rnibor/AgOpenGPS_BoardsKeya/TeensyModules/V4.1/Enclosures/3Dprint/Standard_Special_Screws_AMP/Standard_Special_Screws_AMP.png

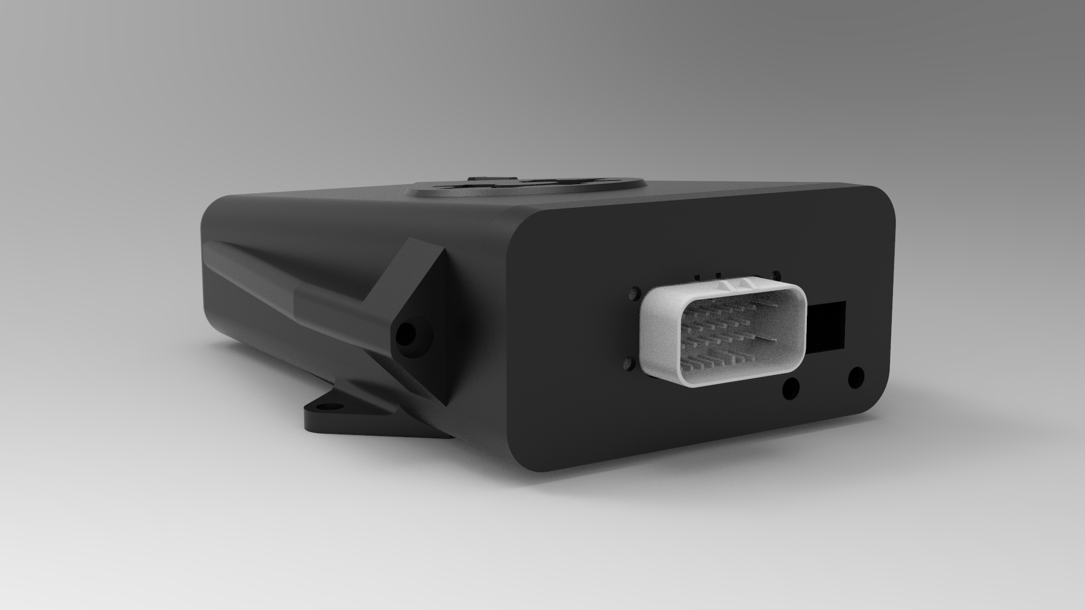
TeensyModules/V4.1/Enclosures/3Dprint/Standard_Special_Screws_AMP/Standard_Special_Screws_AMP.png
