rnibor/AgOpenGPS_BoardsKeya/TeensyModules/V4.1/Enclosures/3Dprint/Standard_Special_AMP/Standard_Special_AMP.jpg

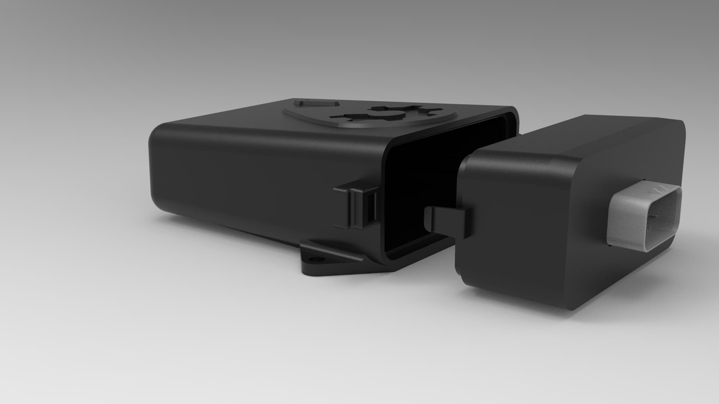
TeensyModules/V4.1/Enclosures/3Dprint/Standard_Special_AMP/Standard_Special_AMP.jpg
