rnibor/AgOpenGPS_BoardsKeya/TeensyModules/V2.5/All In One Board Help.pdf

# AgOpenGPS - ALL in One PCB

## 1. Standard or Micro

The first choice that we will have to make is which model of GPS receiver we are going to use:

Standard

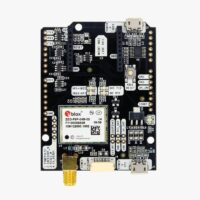
[picture p3: figure]

https://www.ardusimple.com/product/simplertk2b/

Micro

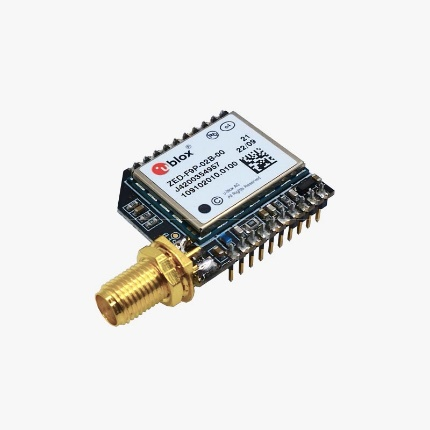
[picture p4: figure]

https://www.ardusimple.com/product/simplertk2b-micro/Options :
RF connector --------> SMA
Form Factor----------> Through hole

### 2. ANTENNA

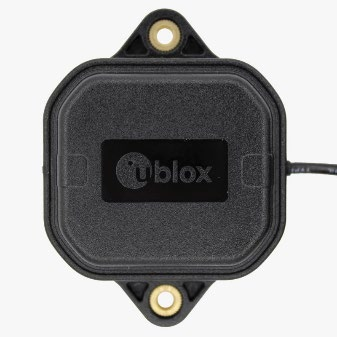
[picture p5: figure]

https://www.ardusimple.com/product/ann-mb-00-ip67/

### 3. SINGLE OR DUAL

This choice is not important for the PCB model that you are going to make, it is only important to buy the receivers and antennas.

### 4. HOW ORDER/BUILD PCB

We use the JCLPCB service to manufacture our PCBs, but you can use another supplier if you prefer.

https://jlcpcb.com/

1.- Click on Order Now (https://cart.jlcpcb.com/quote) to access the page to place the order

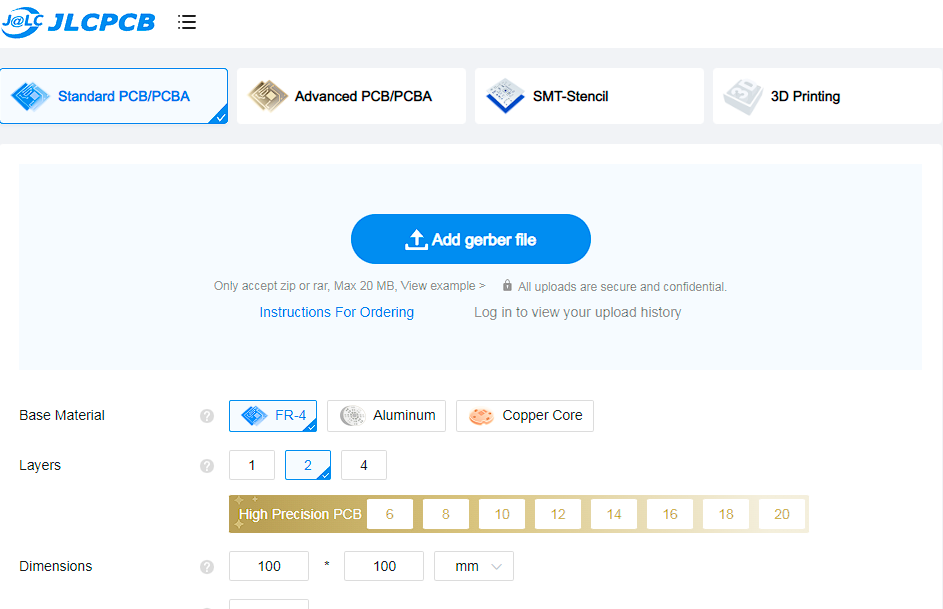
[picture p6: figure]

2.- Add gerber file, this files contents all info about PCB desing, these files are located in AgOpenGPS/Support/TeensyModules/Board

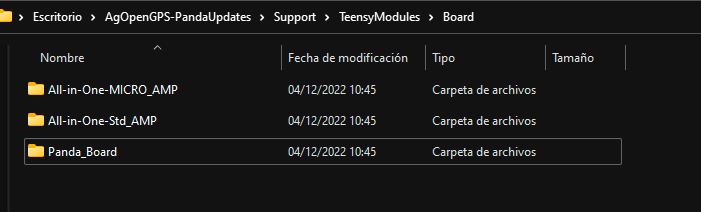
[picture p7: figure]

3.- We will use the Micro or Standard folder depending on our choice of receiver

4.- Inside each folder we will find three files that we are going to use

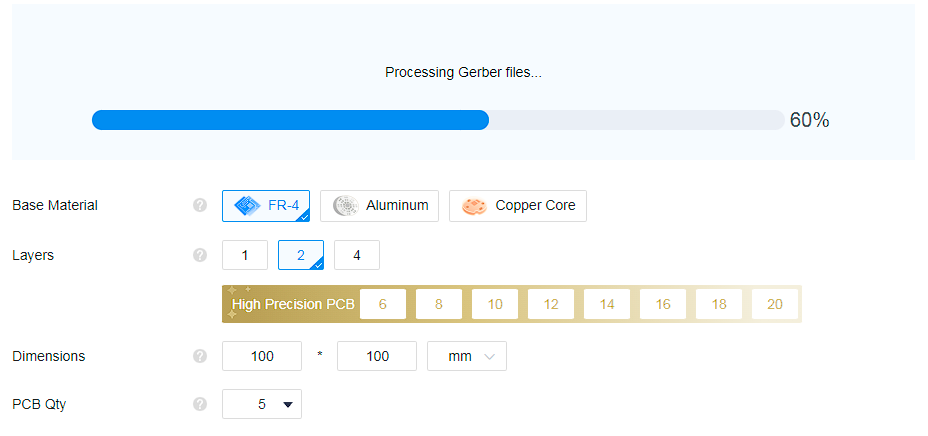
[picture p8: figure]

5.- Upload Gerber.zip file in JCLPCB

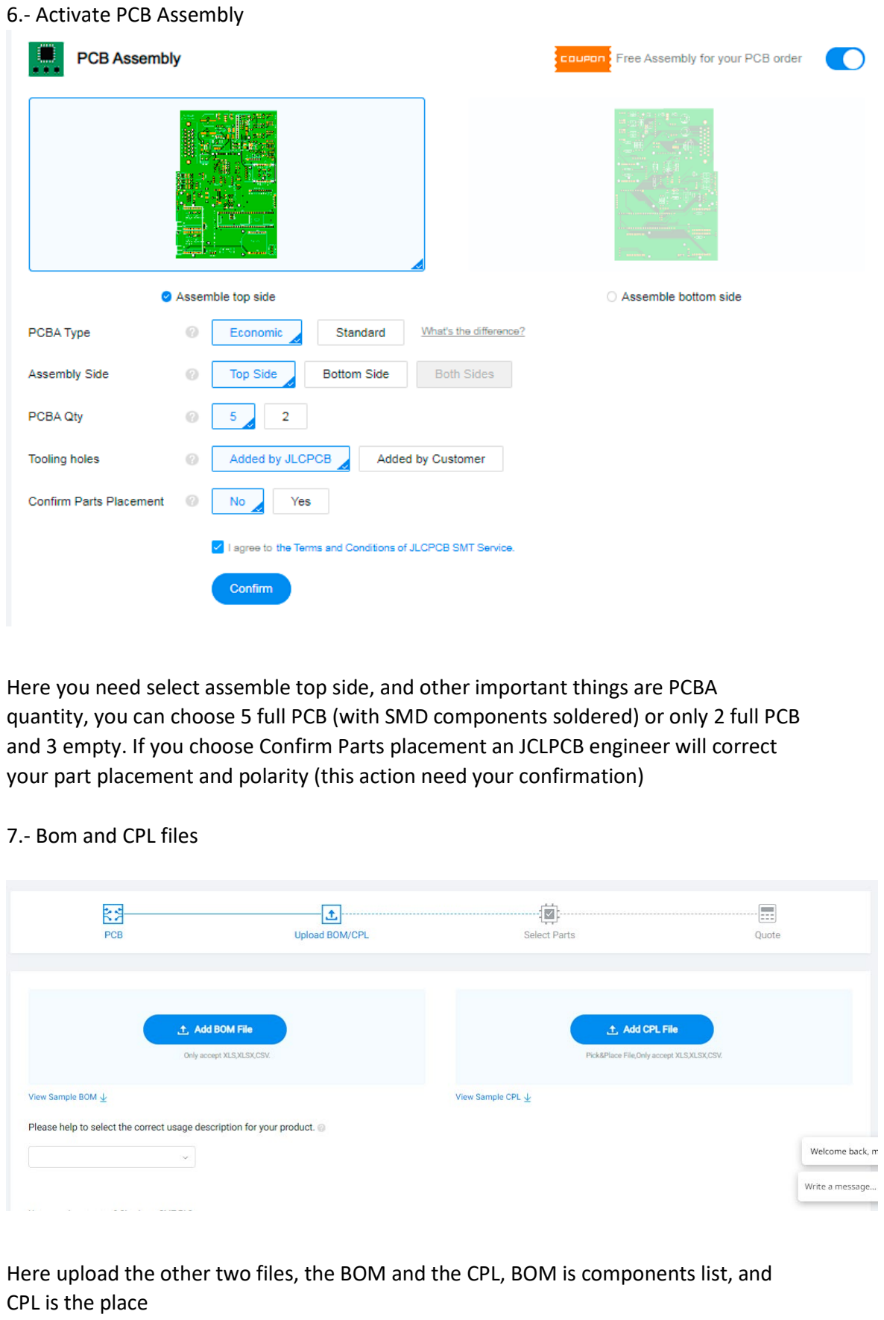
[picture p9: page 4]

6.- Activate PCB Assembly

Here you need select assemble top side, and other important things are PCBA quantity, you can choose 5 full PCB (with SMD components soldered) or only 2 full PCB and 3 empty. If you choose Confirm Parts placement an JCLPCB engineer will correct your part placement and polarity (this action need your confirmation)

7.- Bom and CPL files

Here upload the other two files, the BOM and the CPL, BOM is components list, and CPL is the place

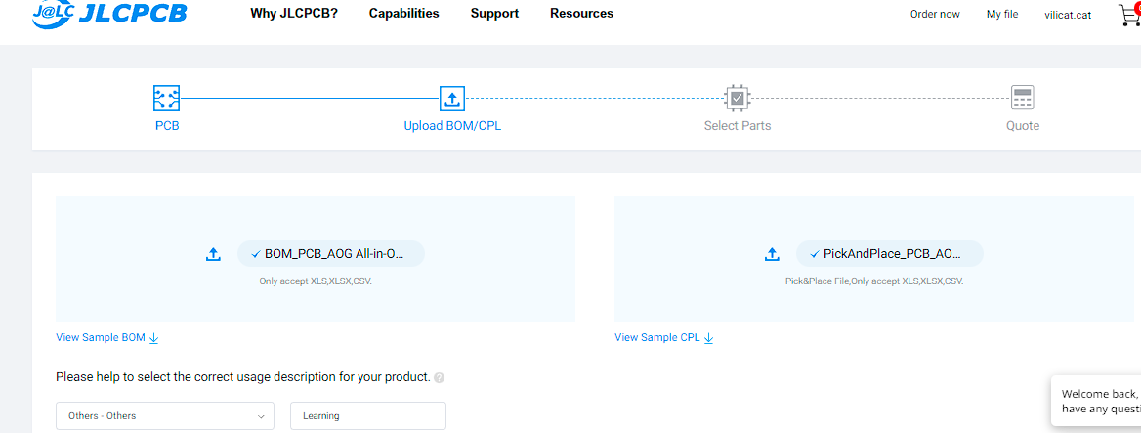
[picture p10: figure]

8.- Select Parts

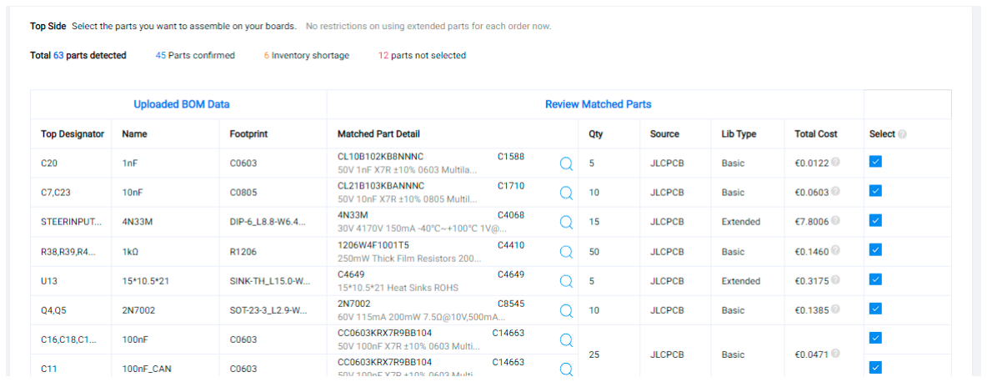
[picture p11: figure]

A list of all the components opens, with all the details of each one, the name, the quantity, the price...

We will have Confirmed parts, Non-selected parts (in red), which are the components that we will have to buy elsewhere (for example, the GPS receiver or the BNO085) and parts in Inventory Storage (restocking) due to supply problems. In these parts you can try to find a substitute in JLCPCB or in another provider (with this last option you will have to solder it yourself).

9.- Quote

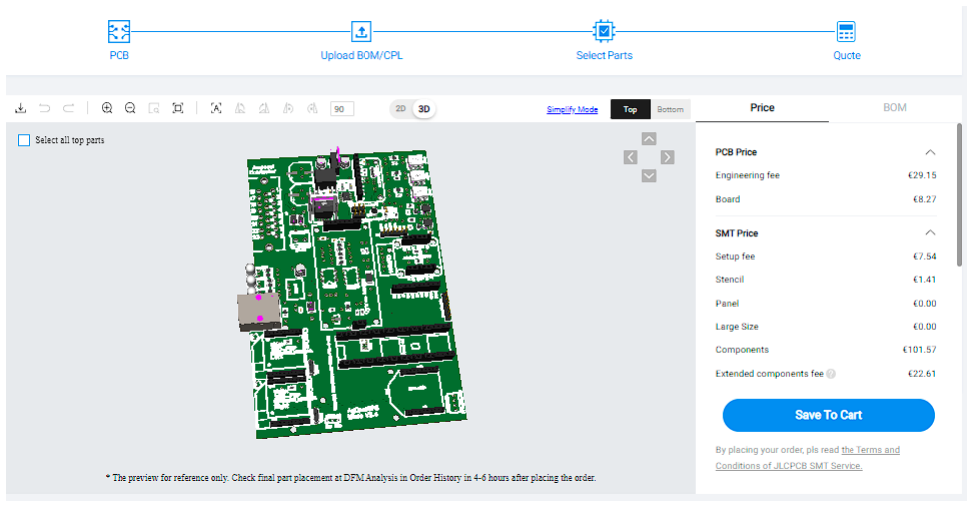
[picture p12: figure]

We are done, we just need to pay and wait for the postman :)

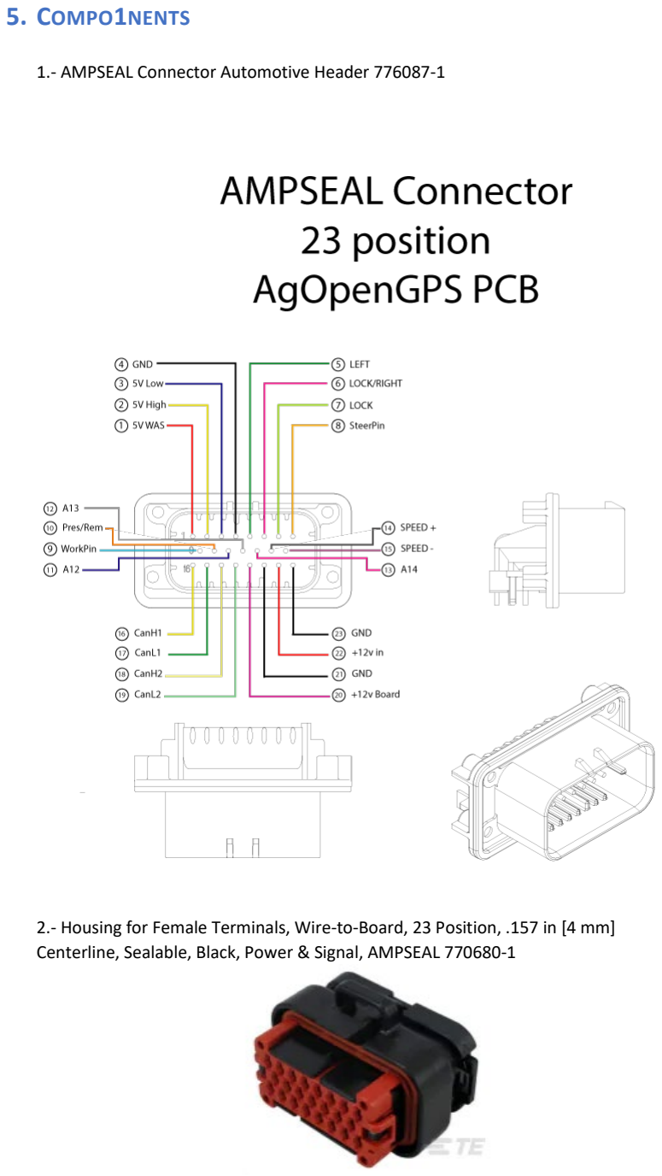
[picture p13: page 7]

### 5. COMPO1NENTS

1.- AMPSEAL Connector Automotive Header 776087-1

2.- Housing for Female Terminals, Wire-to-Board, 23 Position, .157 in [4 mm] Centerline, Sealable, Black, Power & Signal, AMPSEAL 770680-1

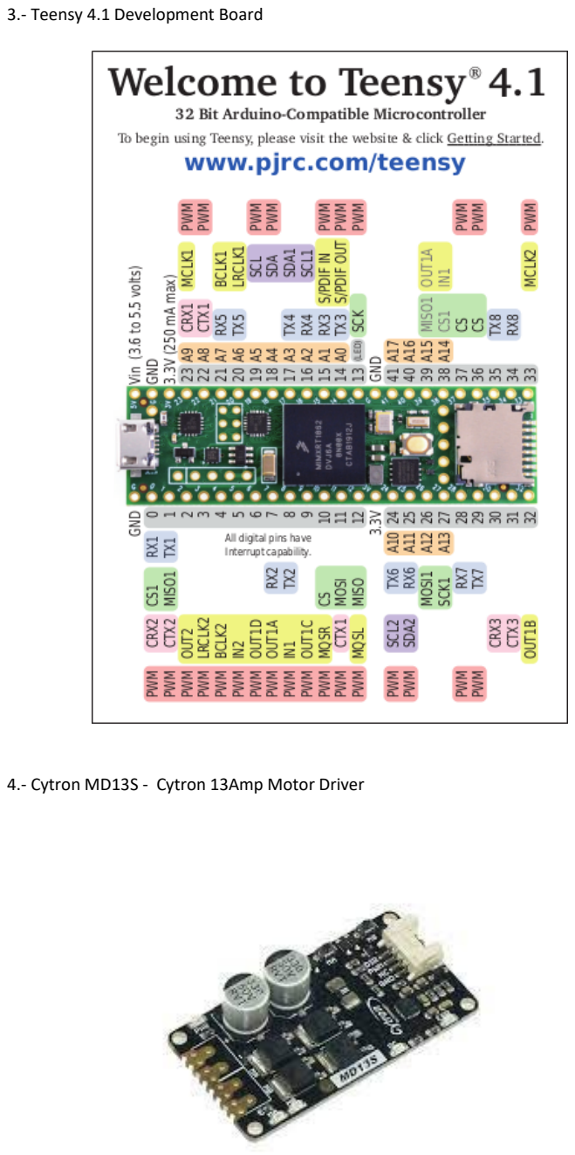
[picture p14: page 8]

3.- Teensy 4.1 Development Board

4.- Cytron MD13S - Cytron 13Amp Motor Driver

5.- WAS (Wheel Angle Sensor)

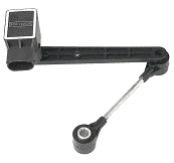
[picture p15: figure]
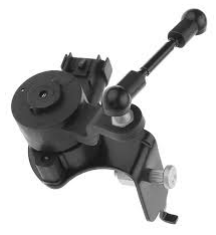
[picture p16: figure]
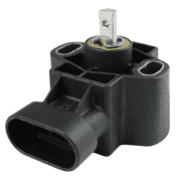
[picture p17: figure]

6.- Optional in Dual receiver, mandatory for single. BNO085X

7.- Jumpers

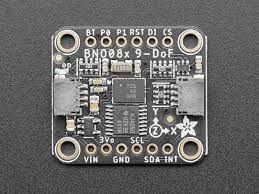
[picture p18: figure]
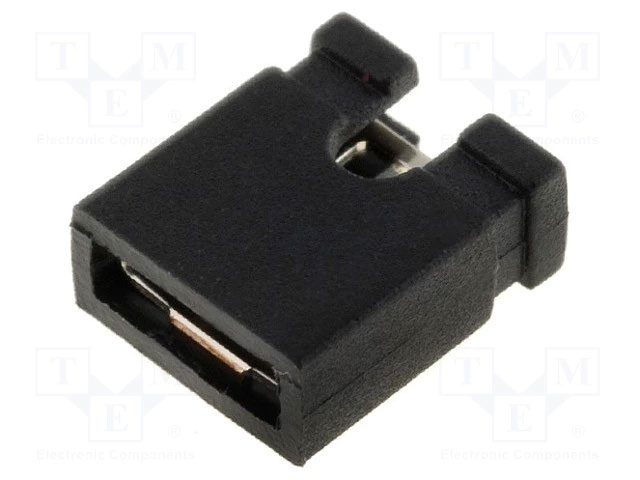
[picture p19: figure]

8.- Power ON switch, optional

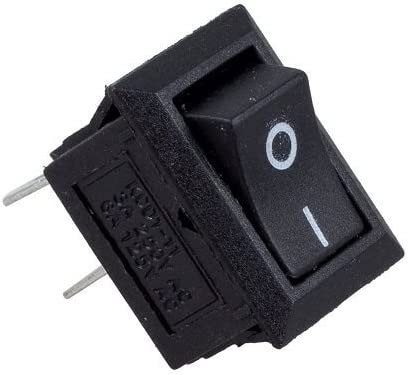
[picture p20: figure]

9.- Ethernet Cable (CAT6 recommended)

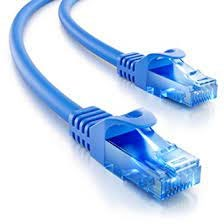
[picture p21: figure]

10.- Tablet Windows (800 nits recommended)

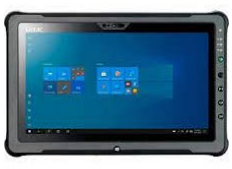
[picture p22: figure]
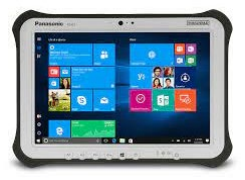
[picture p23: figure]

11.- Motor or Valves

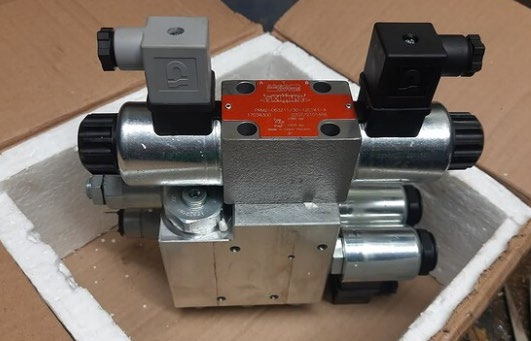
[picture p24: figure]
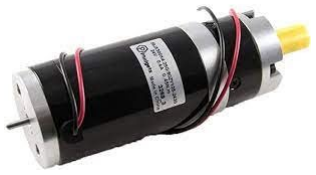
[picture p25: figure]

## 6. WIRINGS AND CONNECTIONS

Component | PIN Optional PIN | Description
Battery + | 22 | | +12v in
Battery - | 23 | 21/4 | GND
WAS 5V | 1 | | Power WAS 5v
WAS GND | 4 | 21/23 | GND WAS
WAS Low | 3 | | Used for differential WAS (Factory installed WAS)
WAS High | 2 | | WAS Signal
Steerswitch | 8 | | ON/OFF Autosteering
Steerswitch GND | 23 | 21/4
Workswitch | 9 | | ON/OFF sections
Workswitch GND | 23 | 21/4
Remote/Pressure | 10 | | Used for pressure sensor in valves or encoder in motor
Remote/Pressure GND | 23 | 21/4
Left | 5 | | Power output for motor/valves
Lock/Right | 6 | | Power output for motor/valves
Lock | 7 | | Used in valves
CanH1 | 16 | | Can High Output channel 1
CanL1 | 17 | | Can Low Output channel 1
CanH2 | 18 | | Can High Output channel 2
CanL2 | 19 | | Can Low Output channel 2
Speed + | 14 | | Output speed pulse +
Speed - | 15 | | Output speed pulse -
A12 | 11 | | !Use at your own risk! Unprotected connection to pin A12
A13 | 12 | | !Use at your own risk! Unprotected connection to pin A13
A14 | 14 | | !Use at your own risk! Unprotected connection to pin A14
+12v Board | 20 | | +12v Output

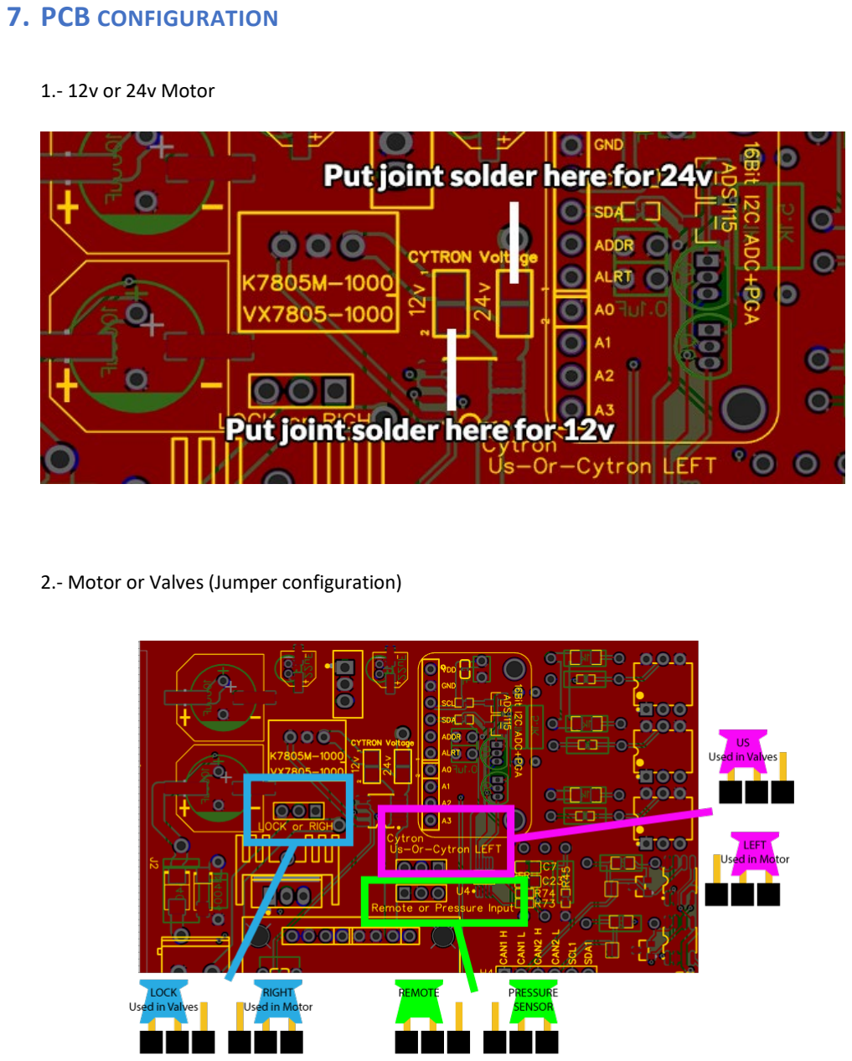
[picture p26: page 12]

### 7. PCB CONFIGURATION

1.- 12v or 24v Motor

2.- Motor or Valves (Jumper configuration)

3.- F9P slot in single mode

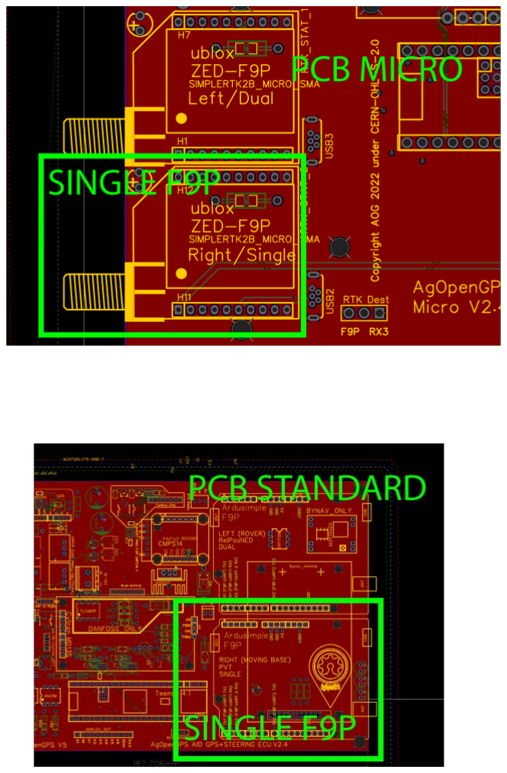
[picture p27: figure]

## 8. READING LEDS

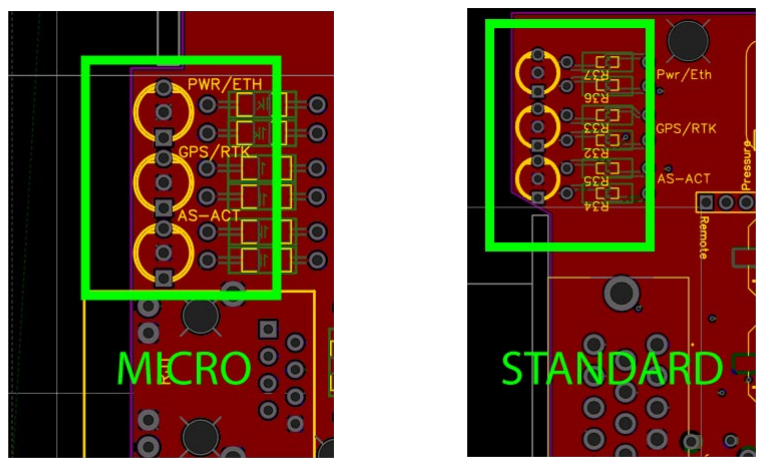
[picture p28: figure]

LED | COLOR
PWR/ETH | RED | Power on
PWR/ETH | GREEN | Ethernet active
GPS/RTK | RED | GPS ON, NO RTK
GPS/RTK | GREEN | GPS ON, RTK ON
AS-ACT | RED | Steer Module connected and enabled; steer switch off
AS-ACT | GREEN | Autosteer connected and enabled

### 9.- FIRMWARE UPLOAD

Teensy uses a special firmware located in :

AgOpenGPS/Support/TeensyModules/Firmware/Autosteer_gps_teensy_vx_x/

vx_x | are a version number e.: v5_5

To upload the firmware we use the Arduino IDE 1.8.xx together with the TeensyArduino plugin, or this plugin is already included in version 2.0.xx of the program.

More info in :

https://www.pjrc.com/teensy/teensyduino.html

### 10.- F9P CONFIGURATION AND FIRMWARE UPLOAD

Config files are located in :

AgOpenGPS/Support/Ublox F9P Configurations/

Config Upload and firmware update :

https://discourse.agopengps.com/t/f9p-firmware-update-and-config-files/8830
