rnibor/AgOpenGPS_BoardsKeya/Misc/CANBUS/PCB/PCB Image.png

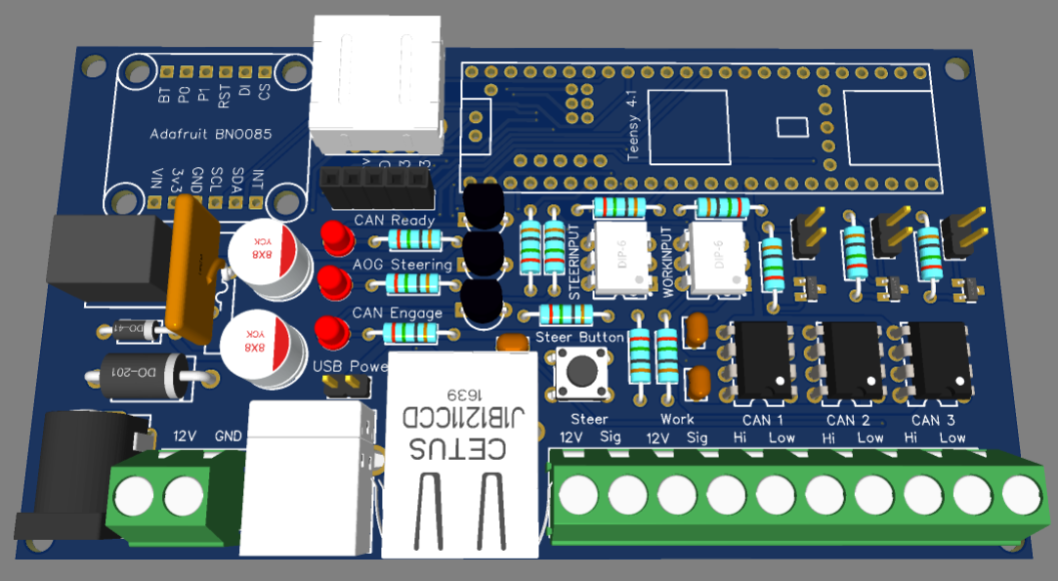
Misc/CANBUS/PCB/PCB Image.png
