rnibor/AgOpenGPS_BoardsKeya/Misc/CANBUS/PCB/Schematic_Teensy 4.1 CAN Ver2_2023-02-23.png

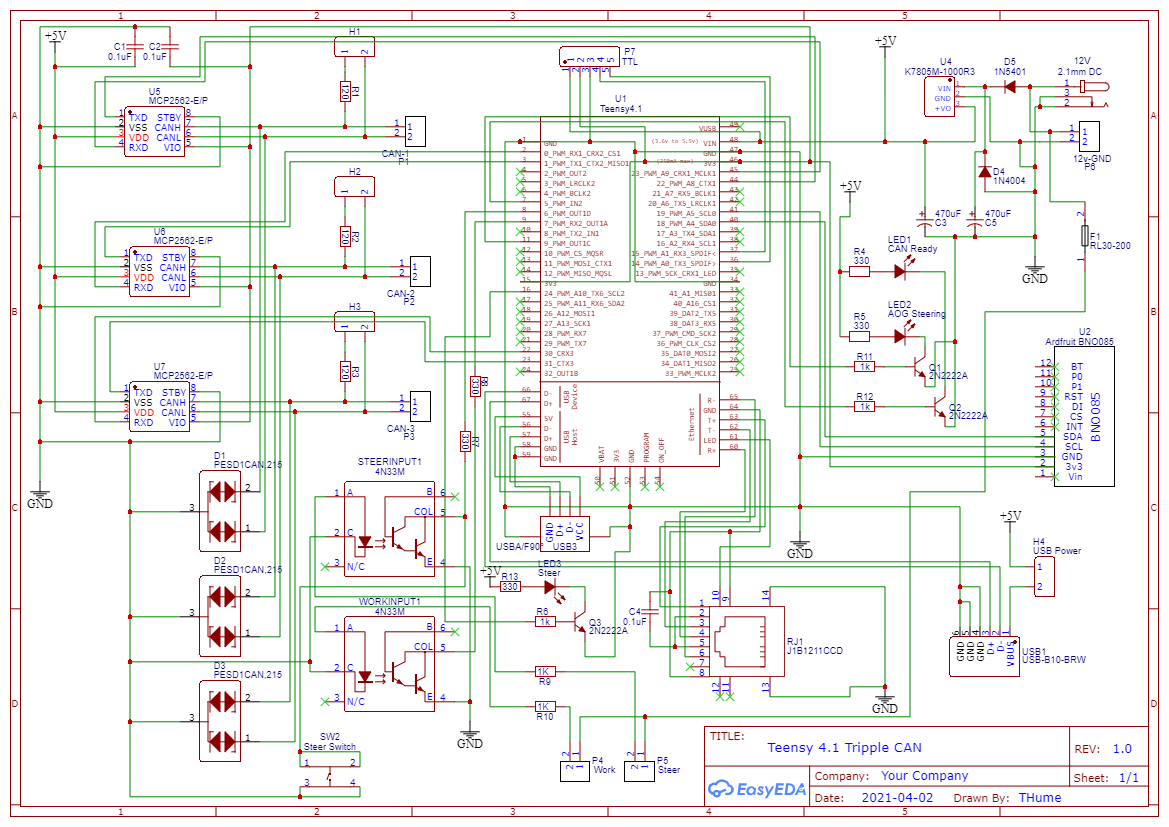
Misc/CANBUS/PCB/Schematic_Teensy 4.1 CAN Ver2_2023-02-23.png
