rnibor/AgOpenGPS_BoardsKeya/Misc/Schematics/steer.png

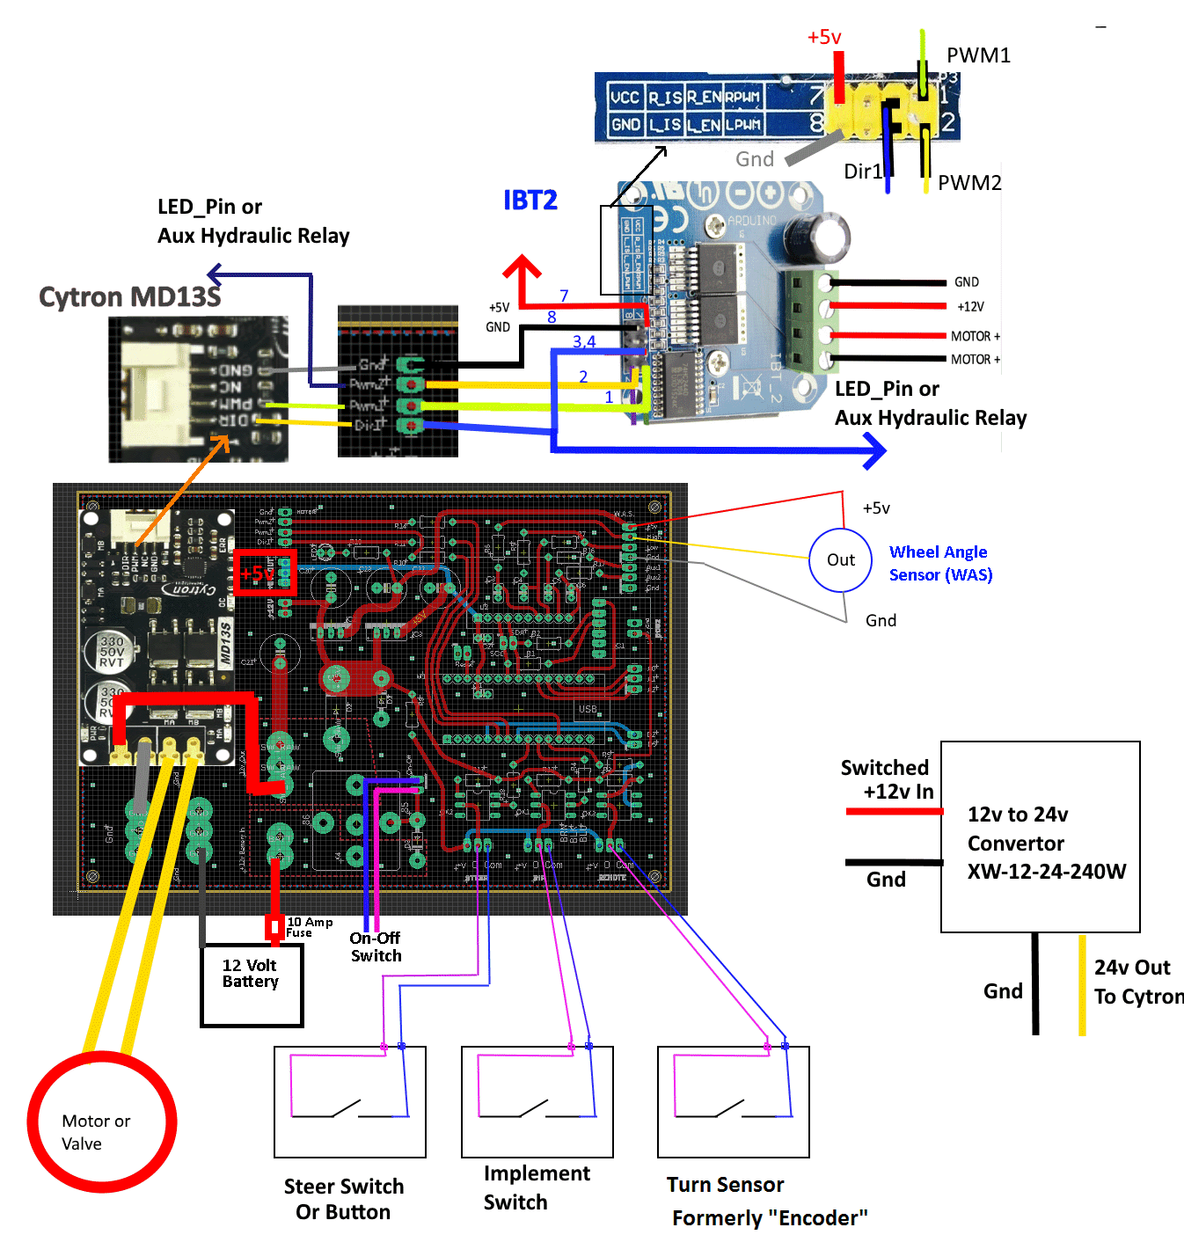
Misc/Schematics/steer.png
