rnibor/AgOpenGPS_BoardsKeya/TeensyModules/4.1 STD/MISC/2d TOP.png

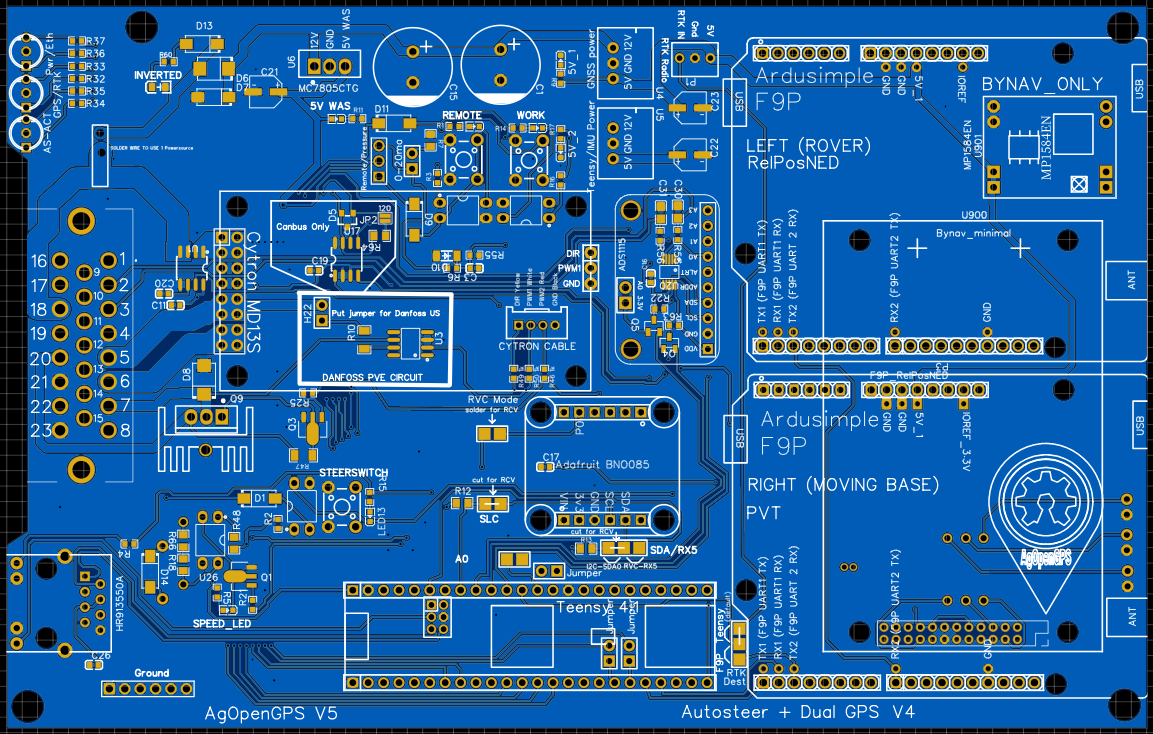
TeensyModules/4.1 STD/MISC/2d TOP.png
