rnibor/AgOpenGPS_BoardsKeya/TeensyModules/V4.1/Enclosures/3Dprint/Micro_AMP/Micro_AMP.jpg

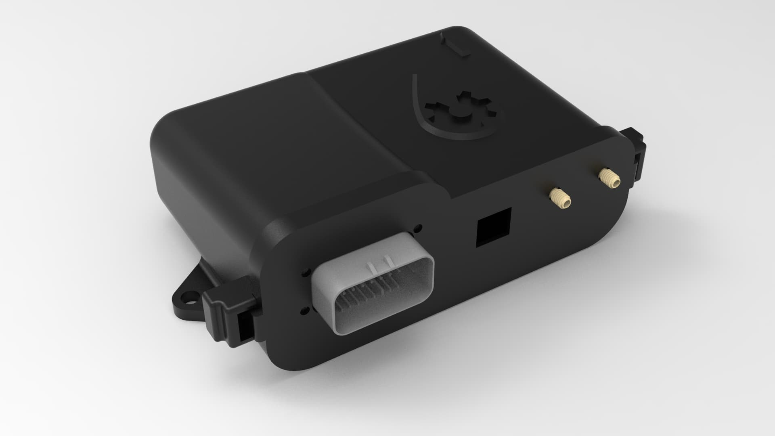
TeensyModules/V4.1/Enclosures/3Dprint/Micro_AMP/Micro_AMP.jpg
