rnibor/AgOpenGPS_BoardsKeya/TeensyModules/V4.1/Enclosures/3Dprint/Micro_Screws_AMP/Micro_Screws_AMP.png

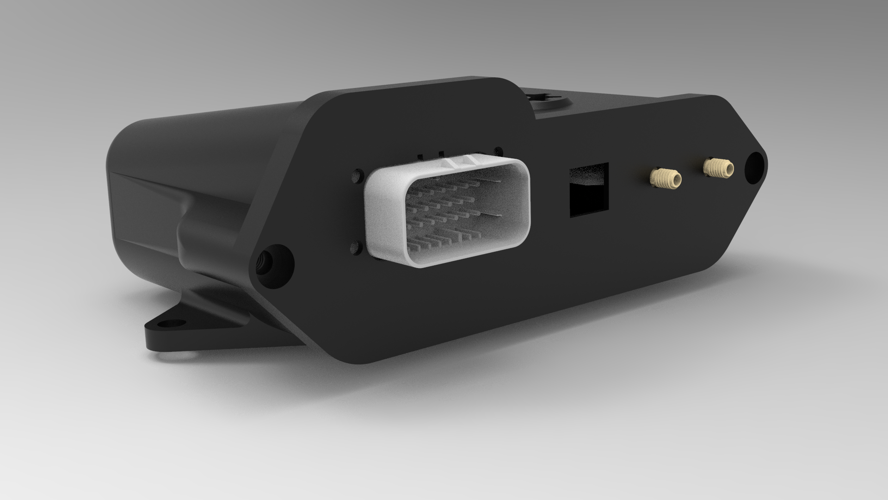
TeensyModules/V4.1/Enclosures/3Dprint/Micro_Screws_AMP/Micro_Screws_AMP.png
