rnibor/AgOpenGPS_BoardsKeya/TeensyModules/V4.1/Enclosures/3Dprint/Standard_AMP/Standard_AMP.png

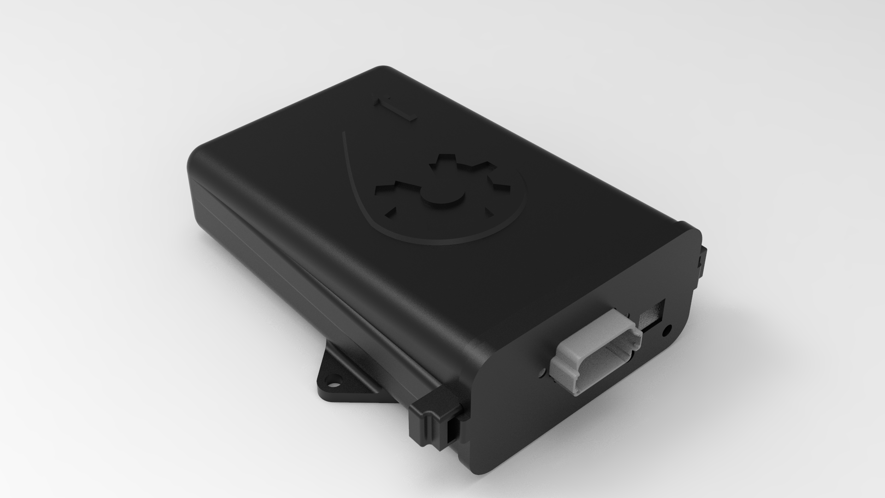
TeensyModules/V4.1/Enclosures/3Dprint/Standard_AMP/Standard_AMP.png
