rnibor/AgOpenGPS_BoardsKeya/TeensyModules/V4.1/Enclosures/3Dprint/Standard_Screws_AMP/Standard_Screws_AMP.jpg

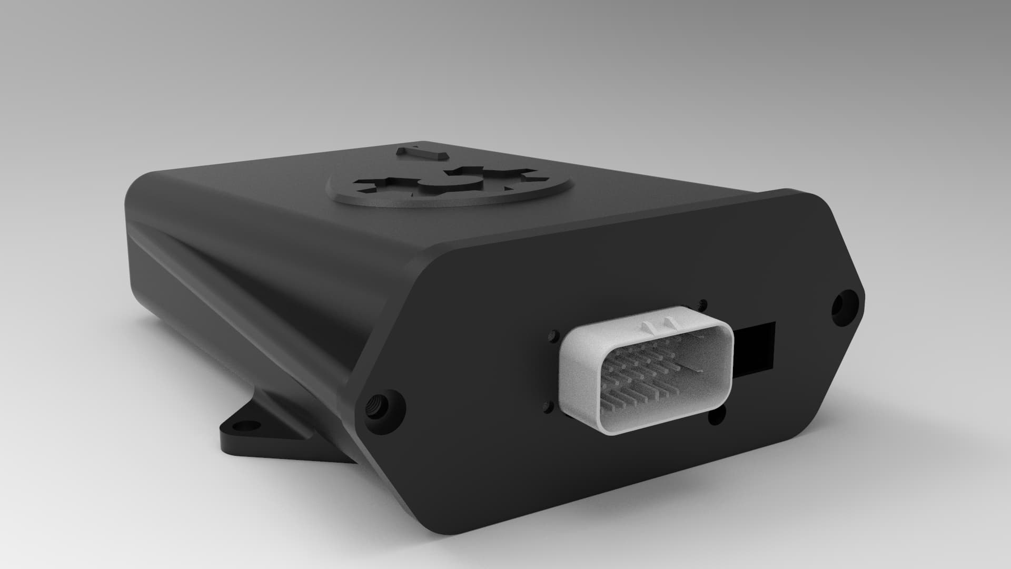
TeensyModules/V4.1/Enclosures/3Dprint/Standard_Screws_AMP/Standard_Screws_AMP.jpg
