rnibor/AgOpenGPS_BoardsKeya/TeensyModules/4.1 STD/BOM/BOM_AiO V4 Standard_2023-06-19.csv

ID | Name | Designator | Footprint | Quantity | Manufacturer Part | Manufacturer | Supplier | Supplier Part | Price
1 | DY-339URUYGW/SN | AS-ACT,GPS/RTK,PWR/ETH | LED-TH_3P-BD5.0-P2.54 | 3 | DY-339URUYGW/SN | TONYU | LCSC | C459134 | 0.067
2 | 1000uF | C1,C15 | CAP-TH_BD13.0-P5.00-D1.2-FD | 2 | 35YXJ1000M12.5X20 | rubycon(红宝石) | LCSC | C88743 | 0.281
3 | 100nF | C3,C16,C17,C19,C26 | C0603 | 5 | CC0603KRX7R9BB104 | YAGEO | LCSC | C14663 | 0.002
4 | 100nF_CAN | C11 | C0603 | 1 | CC0603KRX7R9BB104 | YAGEO | LCSC | C14663 | 0.002
5 | 22uF | C14 | CAP-TH_BD4.0-P1.50-D0.8-FD | 1 | 22uF 16V 4*7 | ValuePro | LCSC | C43845 | 0.007
6 | 1nF | C20 | C0603 | 1 | CL10B102KB8NNNC | SAMSUNG | LCSC | C1588 | 0.003
7 | 22uF | C21,C22,C23 | CAP-SMD_BD5.0-L5.3-W5.3-FD | 3 | VT1V220M0505 | ROQANG | LCSC | C239256 | 0.031
8 | 10nF | C30,C31 | C0805 | 2 | CL21B103KBANNNC | SAMSUNG | LCSC | C1710 | 0.009
9 | HEADER_ethernet-2X3P | CN2 | HDR-TH_6P-P2.00-V-F-R2-C3-S2.00 | 1 | A2005HWV-2x3P | Changjiang Connectors | LCSC | C225302 | 0.163
10 | 1N4004_C727080 | D1,D9,D11,D14 | SMA_L4.4-W2.8-LS5.4-RD | 4 | 1N4004 | TWGMC | LCSC | C727080 | 0.009
11 | PESD1CAN,215 | D5 | SOT-23_L2.9-W1.3-P1.90-LS2.4-BR | 1 | PESD1CAN,215 | Nexperia | LCSC | C15771 | 0.117
12 | S3M | D6,D8 | SMB_L4.6-W3.6-LS5.3-RD | 2 | S3M | MDD | LCSC | C47524 | 0.03
13 | 1N4004 | D7,D13 | SMA_L4.4-W2.8-LS5.4-RD | 2 | 1N4004 | TWGMC | LCSC | C727080 | 0.009
14 | ZMM3V3 | D10 | LL-34_L3.5-W1.5-RD | 1 | ZMM3V3-M | ST(先科) | LCSC | C8056 | 0.012
15 | 1N4004 | D15 | DO-41_BD2.4-L4.7-P8.70-D0.9-FD | 1 | 1N4004 | MDD | LCSC | C3058 | 0.017
16 | 0-20ma | H4 | HDR-TH_2P-P2.54-V-M-1 | 1 |  |  | LCSC | C2905434 | 0.018
17 | HEADER_F9P | H6,H7 | HDR-TH_10P-P2.54-V-F | 2 | PM254-1-10-Z-8.5 | HCTL(华灿天禄) | LCSC | C2897373 | 0.152
18 | HEADER_3PIN | H8 | HDR-TH_3P-P2.54-V-F | 1 |  |  | LCSC | C146243 | 0.056
19 | HEADER_ADS-MCP6002 | H9 | HDR-F-2.54_1X10 | 1 |  |  | LCSC | C2897373 | 0.152
20 | 22850102ANG1SYA02 | H10 | HDR-TH_2P-P2.54-V-F | 1 | 22850102ANG1SYA02 | JILN(锦凌) | LCSC | C429966 | 0.033
21 | Remote/Pressure | H11 | HDR-TH_3P-P2.54-V-M-1 | 1 | Header2.54mm 1*3P | BOOMELE | LCSC | C49257 | 0.014
22 | HEADER_F9P | H13,H14 | HDR-TH_6P-P2.54-V-F | 2 | PM254-1-06-Z-8.5 | HCTL(华灿天禄) | LCSC | C2897369 | 0.108
23 | HEADER_BNO | H18,H19 | HDR-TH_6P-P2.54-V-F | 2 | PM254-1-06-Z-8.5 | HCTL(华灿天禄) | LCSC | C2897369 | 0.108
24 | Danfoss Us | H22 | HDR-TH_2P-P2.54-V-M-1 | 1 |  |  | LCSC | C2905434 | 0.018
25 | AMPSEAL 23 - 776087-1 | J2 | 7760871 | 1 |  |  |  | C378893 | 8.459
26 | HEADER_Cytron 2x8 | J3 | HDR-TH_16P-P2.54-V-F-R2-C8-S2.54-1 | 1 | 2.54-2*8P母 | BOOMELE(博穆精密) | LCSC | C30734 | 0.113
27 | DT13-12PA | K1 | DT13-12PA | 1 | DT13-12PA | DEUTSCH DT
28 | Ant2 | LED1 | LED-TH_BD5.9-P2.54-RD_GREEN | 1 | LTL-307G | Lite-On | LCSC | C125080 | 0.078
29 | Ant1 | LED2 | LED-TH_BD5.9-P2.54-RD_GREEN | 1 | LTL-307G | Lite-On | LCSC | C125080 | 0.078
30 | DIFF | LED3 | LED-TH_BD5.9-P2.54-RD_GREEN | 1 | LTL-307G | Lite-On | LCSC | C125080 | 0.078
31 | 5V_2 | LED4 | LED0603-RD | 1 | 19-217/GHC-YR1S2/3T | EVERLIGHT(亿光) | LCSC | C72043 | 0.027
32 | 5V_1 | LED5 | LED0603-RD | 1 | 19-217/GHC-YR1S2/3T | EVERLIGHT(亿光) | LCSC | C72043 | 0.027
33 | Work_LED | LED6 | LED0603-RD | 1 | 19-217/BHC-ZL1M2RY/3T | EVERLIGHT(亿光) | LCSC | C72041 | 0.018
34 | 5V WAS | LED7 | LED0603-RD | 1 | 19-217/GHC-YR1S2/3T | EVERLIGHT(亿光) | LCSC | C72043 | 0.027
35 | SPEED_LED | LED12 | LED0603-RD | 1 | 19-213/Y2C-CQ2R2L/3T(CY) | EVERLIGHT(亿光) | LCSC | C72038 | 0.023
36 | Steer_LED | LED13 | LED0603-RD | 1 | 19-217/BHC-ZL1M2RY/3T | EVERLIGHT(亿光) | LCSC | C72041 | 0.018
37 | Remote_LED | LED14 | LED0603-RD | 1 | 19-217/BHC-ZL1M2RY/3T | EVERLIGHT(亿光) | LCSC | C72041 | 0.018
38 | INVERTED | LED18 | LED0805-RD | 1 | NCD0805R1 | 国星光电 | LCSC | C84256 | 0.011
39 | HEADER_F9P | P5,P6,P7,P8 | HDR-TH_8P-P2.54-V-F-1 | 4 | 2.54-1*8P母环保 | BOOMELE(博穆精密) | LCSC | C27438 | 0.07
40 | 2SC2884 160-320 PY1 | Q1 | SOT-89-3_L4.5-W2.5-P1.50-LS4.2-BR | 1 | 2SC2884 160-320 PY1 | CJ | LCSC | C24205 | 0.08
41 | 2SC2884 | Q3 | SOT-89-3_L4.5-W2.5-P1.50-LS4.2-BR | 1 | 2SC2884 160-320 PY1 | CJ | LCSC | C24205 | 0.08
42 | 2N7002 | Q4,Q5 | SOT-23-3_L2.9-W1.3-P1.90-LS2.4-BR | 2 | 2N7002 | CJ | LCSC | C8545 | 0.015
43 | IRF5305PBF | Q9 | TO-220-3_L10.0-W4.5-P2.54-T | 1 | IRF5305PBF | Infineon(英飞凌) | LCSC | C2623 | 0.624
44 | 1k | R1,R4,R6,R14,R15,R21,R25,R46,R49,R50,R60 | R0603 | 11 | RMC06031K1%N | Tyohm(幸亚电阻) | LCSC | C269704 | 0.003
45 | 270Ω | R2,R3,R16 | R0603 | 3 | 0603WAF2700T5E | UNI-ROYAL(厚声) | LCSC | C22966 | 0.001
46 | 2K | R5,R55 | R0603 | 2 |  |  | LCSC
47 | 200Ω | R7,R48,R66 | R0805 | 3 | 0805W8F2000T5E | UNI-ROYAL(厚声) | LCSC | C17540 | 0.002
48 | 1k | R8,R29,R31 | RES-TH_BD2.4-L6.3-P10.30-D0.6 | 3 | RD 1/2WS 1K J T/B A1 | TyoHM | LCSC | C433798 | 0.007
49 | 5.1kΩ | R9,R11,R17,R22,R63 | R0603 | 5 | 0603WAF5101T5E | UniOhm | LCSC | C23186 | 0.001
50 | 1kΩ | R10 | R1206 | 1 | 1206W4F1001T5E | UniOhm | LCSC | C4410 | 0.003
51 | 2.2kΩ | R12,R13 | R0805 | 2 | 0805W8F2201T5E | UniOhm | LCSC | C17520 | 0.002
52 | 120Ω | R18,R64 | R0805 | 2 | 0805W8F1200T5E | UniOhm | LCSC | C17437 | 0.002
53 | 330Ω | R32,R33,R34,R35,R36,R37 | R0603 | 6 | 0603WAF3300T5E | UniOhm | LCSC | C23138 | 0.001
54 | 10kΩ | R47 | R1206 | 1 | 1206W4F1002T5E | UniOhm | LCSC | C17902 | 0.003
55 | 1.5kΩ | R53,R56 | R0603 | 2 | 0603WAF1501T5E | UniOhm | LCSC | C22843 | 0.001
56 | 330 | R65 | RES-TH_BD2.4-L6.3-P10.30-D0.6 | 1 | RD 1/2WS 1K J T/B A1 | TyoHM | LCSC
57 | PC817X3NSZ9F | REMOTEOPTO1,STEEROPTO1,U26,WORKOPTO1 | DIP-4_L4.6-W6.5-P2.54-LS7.6-BL | 4 | PC817X3NSZ9F | SHARP(夏普) | LCSC | C96006 | 0.089
58 | HR913550A | RJ1 | RJ45-TH_HR913550A | 1 | HR913550A | HANRUN | LCSC | C163507 | 1.138
59 | 1TS005A-2500-5001 | SW1_THT,SW2_THT,SW3_THT | SW-TH_4P-L6.0-W6.0-P3.90-LS6.5 | 3 | 1TS005A-2500-5001 | HYP(鸿源精密) | LCSC | C255811 | 0.027
60 | ACS712ELCTR-05B-T | U1 | SOIC-8_L5.0-W4.0-P1.27-LS6.0-BL | 1 | ACS712ELCTR-05B-T | ALLEGRO | LCSC | C44471 | 2.725
61 | TC4427AEOA713 | U3 | SOIC-8_L4.9-W3.9-P1.27-LS6.0-BL | 1 | TC4427AEOA713 | MICROCHIP(美国微芯) | LCSC | C20551 | 0.966
62 | GNSS power | U4 | PWRM-TH_K7805M-1000R3 | 1 | K7805M-1000R3 | MORNSUN | LCSC | C132362 | 2.981
63 | Teensy/IMU Power | U5 | PWRM-TH_K7805M-1000R3 | 1 | K7805M-1000R3 | MORNSUN | LCSC | C132362 | 2.981
64 | MC7805CTG | U6 | TO-220-3_L10.0-W4.5-P2.54-T | 1 |  | ON | LCSC | C22456 | 0.466
65 | Header_20pin | U7,U8 | HDR-TH_20P-P2.54-V-F_1.02MM | 2 | 2.54mm 1*20P Female header | BOOMELE | LCSC | C50984 | 0.147
66 | HEADER_TEENSY | U9 | HDR-TH_4P-P2.54-V-F | 1 | FH-00133 | Liansheng(连盛) | LCSC | C2685089 | 0.052
67 | HEADER_TEENSY | U10,U11 | HDR-TH_24P-P2.54-V-F | 2 | X6511FV-24-C85D32 | XKB Connectivity(中国星坤) | LCSC | C2883741 | 0.52
68 | HEAT_SINK | U13 | SINK-TH_L15.0-W10.5-H21.0 | 1 | - | Made in China | LCSC | C4649 | 0.078
69 | MCP2562-E/SN | U17 | SOIC-8_L5.0-W4.0-P1.27-LS6.0-BL | 1 | MCP2562-E/SN | MICROCHIP | LCSC | C53609 | 1.041
70 | ADS1115IDGSR | U20 | MSOP-10_L3.0-W3.0-P0.50-LS5.0-BL | 1 | ADS1115IDGSR | TI | LCSC | C37593 | 3.257
71 | HEADER_TEENSYY | U902 | HDR-TH_4P-P2.54-V-F | 1 | FH-00133 | Liansheng(连盛) | LCSC | C2685089 | 0.052
