rnibor/AgOpenGPS_BoardsKeya/Misc/CANBUS/PCB/Teensy LCSC Parts.xlsx

LCSC Part Number | Manufacture Part Number |  | Order Qty.
C21019 | RL30-200 | Fuse | 5
C433771 | RD 1/4W 120R J T/B A1 | Resistor | 50
C402216 | 1N5408 | Diode | 10
C393938 | TS665CJ | Button | 50
C194407 | DC-470-2.1GP | Power Connector | 10
C8465 | WJ500V-5.08-2P | Screw terminal | 30
C5305 | C5305 | Jumper | 50
C3090 | RL207 | Diode | 20
C714300 | CF1/4W-1KÎ©Â±5%T52 | Resistor | 50
C433729 | RD 1/4W 330R J T/B A1 | Resistor | 50
C254069 | CC1H104ZC1PD3F5P30MF | Capacitor | 20
C190817 | Z-10006320100100 | 6pin DIP socket | 10
C47888 | KM477M035F16RR0VH2FP0 | Capacitor | 10
C4068 | 4N33M | Optocoupler | 10
C115171 | Z-100083200100100 | 8pin DIP socket | 15
C124363 | B-2102S60P-B110 | 2mm double row header | 2
C138806 | B-2202S80P-B121 | 2mm double row header | 2
C118536 | 2N2222A | Transistor | 20
C568935 | HL-304H3GD | 3mm LED | 20
C132362 | K7805M-1000R3 | Power Requlator | 5
C720549 |  | USB-B Socket | 5
J1B1211CCD | Ethernet Socket | AliExpress | 5
MCP2562 | MCP2562-E/P-ND | CANBUS Transceiver - Digikey | ?
