rnibor/AgOpenGPS_BoardsKeya/TeensyModules/V4.5 Micro Keya/PCB Build/AIO v4.5 Micro Keya/OTHER USEFULL PARTS.xlsx

OTHER USEFULL PARTS
NAME | DESCRIPTION | NEEDED? | SUPPLIER | SUPLIER NUMBER
TEENSY |  | YES
BNO085 |  | OPTIONAL
micro F9P |  | YES
CYTRON MD13S |  | Yes, exept DANFOSS
mini ATO fuse |  | YES
ampseal connector
hammond box
