rnibor/AgOpenGPS_BoardsKeya/TeensyModules/V4.5 Micro Keya/PCB Build/AIO v4.5 Micro Keya/files for JLCPCB order/BOM_AiO v4 Micro Robin_PCB_AIO v4.5 Micro AMP 2024 Robin_2024-07-01.xlsx

No. | Name | Designator | Quantity | Manufacturer Part | Manufacturer | Supplier Part | Supplier
1 | DY-339URUYGW/SN | AS-ACT1,GPS/RTK1,PWR/ETH1 | 3 | DY-339URUYGW/SN | TONYU | C459134 | LCSC
2 | 10nF | C7,C23 | 2 | CL21B103KBANNNC | SAMSUNG | C1710 | LCSC
3 | 100uF | C8,C9,C10 | 3 | TAJB107K006RNJ | Kyocera AVX | C16133 | LCSC
4 | 100nF,100nF_CAN | C11,C16,C26 | 3 | CC0603KRX7R9BB104 | YAGEO | C14663 | LCSC
5 | 1000uF | C15,C17 | 2 | 35YXJ1000M12.5X20 | rubycon(红宝石) | C88743 | LCSC
6 | A2005HWV-2X3P | CN2 | 1 |  |  | C2906071 | LCSC
7 | DB128V-5.08-6P-GN-S | CN3 | 1 | DB128V-5.08-6P-GN-S | DORABO(地博电气) | C2915642 | LCSC
8 | DB128V-5.08-4P-GN-S | CN4,CN5 | 2 | DB128V-5.08-4P-GN-S | DORABO(地博电气) | C2915641 | LCSC
9 | SM4007PL | D4,D7,D9,D11,D13,D14,D42,D43,D44,D45 | 10 | SM4007PL | MDD | C64898 | LCSC
10 | PESD1CAN,215 | D5 | 1 | PESD1CAN,215 | Nexperia | C15771 | LCSC
11 | SS54_C22452 | D6 | 1 | SS54 | MDD | C22452 | LCSC
12 | 1N5819WS | D16,D17,D20,D41 | 4 | 1N5819WS | Hottech(合科泰) | C191023 | LCSC
13 | 178.6764.0001 | FH1 | 1 | 178.6764.0001 | Littelfuse(美国力特) | C142933 | LCSC
14 | HEADER_2mm,HEADER_2mm_XBEE | H1,H7,H9,H10,H11,H12 | 6 | C691436 | BOOMELE(Boom Precision Elec) | C691436 | LCSC
15 | HEADER_6PINS | H13,H14 | 2 | PM254-1-06-Z-8.5 | HCTL(华灿天禄) | C2897369 | LCSC
16 | 2.54-1*3P针 | H25,H26 | 2 | 2.54-1*3P针 | BOOMELE(博穆精密) | C49257 | LCSC
17 | MTP125-1102S1 | J2,U31,U35-VUSB1 | 3 | MTP125-1102S1 | MINTRON(明硕) | C358684 | LCSC
18 | 3V3,5V,5V WAS,RTK | LED3,LED4,LED5,LED7,LED8 | 5 | KT-0805翠绿 | KENTO | C2297 | LCSC
19 | DIR_LED,PWM1_LED,PWM2_LED,SPEED_LED | LED9,LED10,LED11,LED12 | 4 | 19-213/Y2C-CQ2R2L/3T(CY) | EVERLIGHT(亿光) | C72038 | LCSC
20 | 0603_RED | LED15,LED16,LED17 | 3 | KT-0603R | null | C2286 | LCSC
21 | Remote,Steer,Work | LED_LIFTED_UP,LED_REMOTE1,LED_SPEED_GEAR,LED_SPEED_RADAR,LED_STEER1,LED_WORK1,SPEED_PTO | 7 | KT-0603白灯 | null | C2290 | LCSC
22 | 2N7002 | Q4,Q5 | 2 | 2N7002 | CJ | C8545 | LCSC
23 | D882_C9634 | Q9 | 1 | D882 Y档160~320 | CJ(江苏长电/长晶) | C9634 | LCSC
24 | 270Ω | R1,R3,R16 | 3 | 0603WAF2700T5E | UNI-ROYAL(厚声) | C22966 | LCSC
25 | 1kΩ | R6,R10,R18,R19,R20,R21,R26,R27,R28,R29,R30,R38,R39,R40,R41,R42,R51,R52,R53,R54,R76,R77,R78,R79,R80,R81,R82,R83 | 28 | 0603WAF1001T5E | UNI-ROYAL(厚声) | C21190 | LCSC
26 | 5.1kΩ | R17,R22,R61,R63 | 4 | 0603WAF5101T5E | UniOhm | C23186 | LCSC
27 | 2kΩ | R23 | 1 | 0603WAF2001T5E | UNI-ROYAL(厚声) | C22975 | LCSC
28 | 200Ω | R48 | 1 | 0805W8F2000T5E | UNI-ROYAL(厚声) | C17540 | LCSC
29 | 120Ω | R64 | 1 | 0805W8F1200T5E | UniOhm | C17437 | LCSC
30 | 2.2kΩ | R71 | 1 | 0805W8F2201T5E | UniOhm | C17520 | LCSC
31 | 1.5kΩ | R73,R74 | 2 | 0603WAF1501T5E | UniOhm | C22843 | LCSC
32 | 330Ω | R84 | 1 | 0805W8F3300T5E | UNI-ROYAL(厚声) | C17630 | LCSC
33 | EL3H7(B)(TA)-G | REMOTEOPTO1,REMOTEOPTO2,REMOTEOPTO3,REMOTEOPTO4,REMOTEOPTO5,SPEEDPULSEOPTO1,STEEROPTO1,WORKOPTO1 | 8 | EL3H7(B)(TA)-G | EVERLIGHT(亿光) | C32565 | LCSC
34 | HR913550A | RJ1 | 1 | HR913550A | HANRUN | C163507 | LCSC
35 | PH2.54-01-03PZD | SJ2 | 1 | PH2.54-01-03PZD | XUNPU(讯普) | C7501581 | LCSC
36 | K7803M-1000R3 | U3 | 1 | K7803M-1000R3 | MORNSUN(金升阳) | C132363 | LCSC
37 | ADS1115IDGSR | U4 | 1 | ADS1115IDGSR | TI | C37593 | LCSC
38 | Teensy/IMU Power | U5 | 1 | K7805M-1000R3 | MORNSUN | C132362 | LCSC
39 | MC7805CTG | U6 | 1 |  | ON | C22456 | LCSC
40 | MCP2562-E/SN | U17 | 1 | MCP2562-E/SN | MICROCHIP | C53609 | LCSC
41 | H_TEENSY | U29,U30 | 2 | X6511FV-24-C85D32 | XKB Connectivity(中国星坤) | C2883741 | LCSC
42 | DB125-2.54-3P-GN-S | U37 | 1 | DB125-2.54-3P-GN-S | DORABO(地博电气) | C918121 | LCSC
43 | MICRO 180°JB | USB2,USB3 | 2 | MICRO 180°JB | SHOU HAN(首韩) | C456007 | LCSC
44 | MX128-2.54-06P-GN01-Cu-Y-A | X38,X39 | 2 | MX128-2.54-06P-GN01-Cu-Y-A | MAX(迈旭) | C5188446 | LCSC
