rnibor/AgOpenGPS_BoardsKeya/TeensyModules/V4.1/Enclosures/3Dprint/Micro_AMP/FrontPanel_AMP_Single.stl

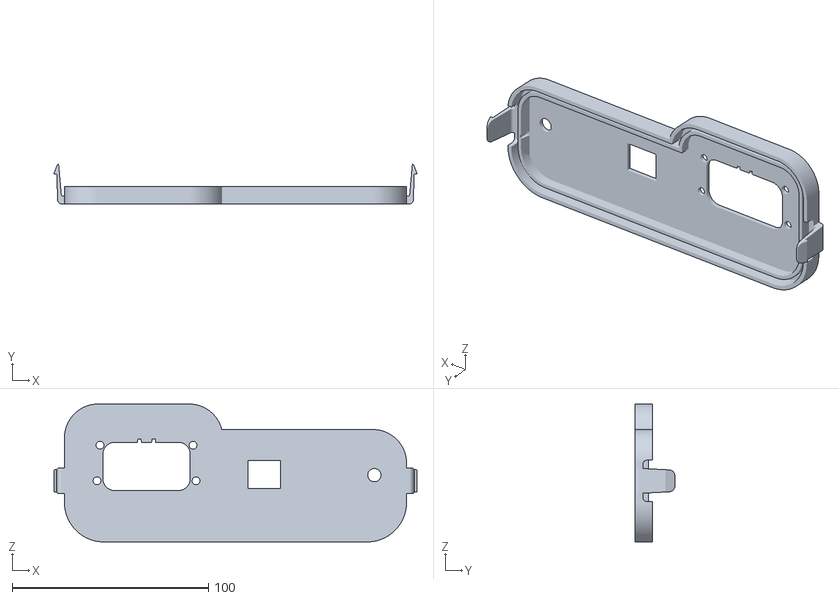
[picture p38: CAD file, 2023-02-05]
TeensyModules/V4.1/Enclosures/3Dprint/Micro_AMP/FrontPanel_AMP_Single.stl
184.8 x 20.3 x 70.2
