rnibor/AgOpenGPS_BoardsKeya/TeensyModules/V4.1/Enclosures/3Dprint/Standard_AMP/FrontPanel_AMP_Dual.stl

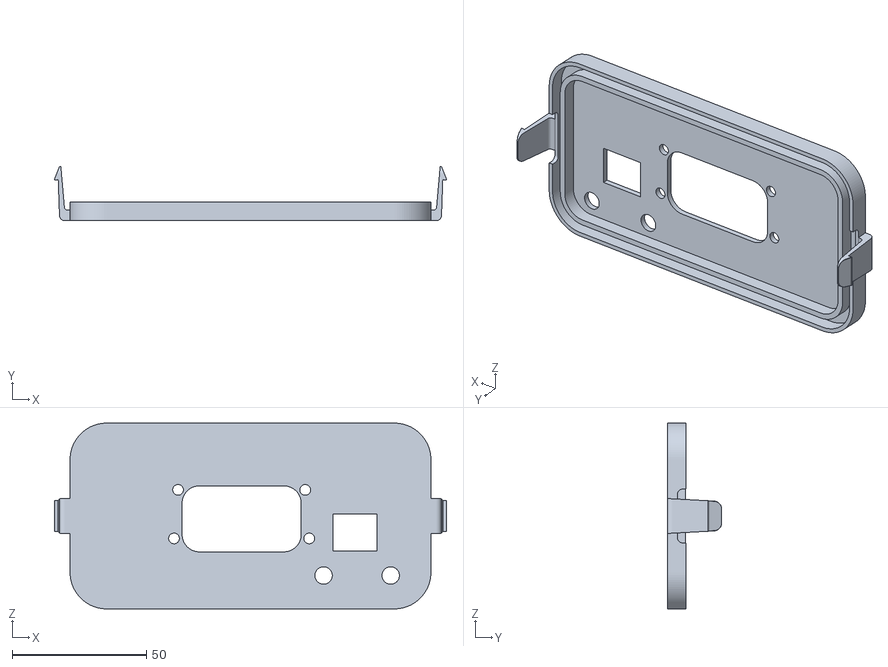
[picture p39: CAD file, 2023-02-05]
TeensyModules/V4.1/Enclosures/3Dprint/Standard_AMP/FrontPanel_AMP_Dual.stl
146.1 x 20.3 x 69.2
