rnibor/AgOpenGPS_BoardsKeya/TeensyModules/V4.1/Enclosures/3Dprint/Standard_Special_AMP/Panel_AMP_Single.stl

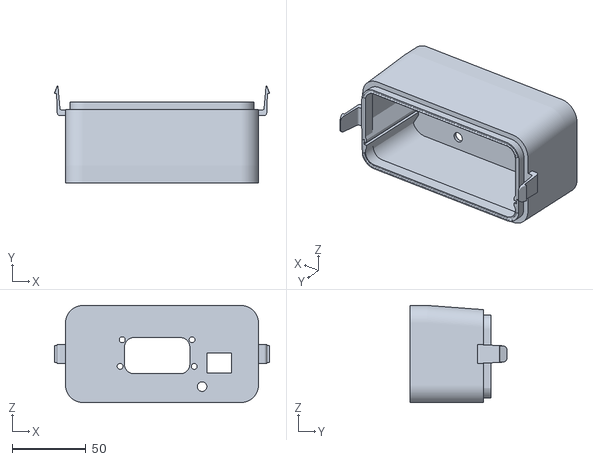
[picture p40: CAD file, 2023-02-05]
TeensyModules/V4.1/Enclosures/3Dprint/Standard_Special_AMP/Panel_AMP_Single.stl
146.1 x 66.1 x 66.0
