rnibor/AgOpenGPS_BoardsKeya/TeensyModules/V4.5 Micro Keya/Enclosures/V1 Starting point/AgOpenGpsV4.5MicroKeyaTop.step

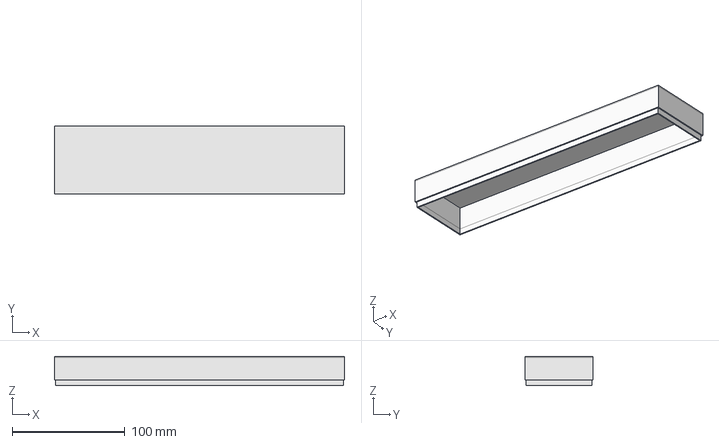
[picture p41: CAD file, 2024-08-05]
TeensyModules/V4.5 Micro Keya/Enclosures/V1 Starting point/AgOpenGpsV4.5MicroKeyaTop.step
257.2 x 60.5 x 26.0 mm
