rnibor/AgOpenGPS_BoardsKeya/TeensyModules/V4.5 Micro Keya/Enclosures/V1 Starting point/AgOpenGpsV4.5MicroKeyaBottom.step

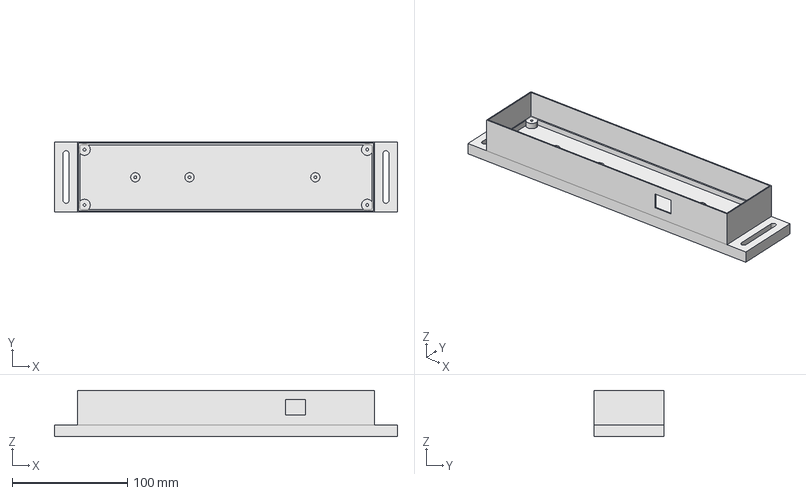
[picture p42: CAD file, 2024-08-05]
TeensyModules/V4.5 Micro Keya/Enclosures/V1 Starting point/AgOpenGpsV4.5MicroKeyaBottom.step
297.2 x 60.5 x 40.0 mm
