rnibor/AgOpenGPS_BoardsKeya/TeensyModules/V4.1/Enclosures/3Dprint/Micro_AMP/Box.stl

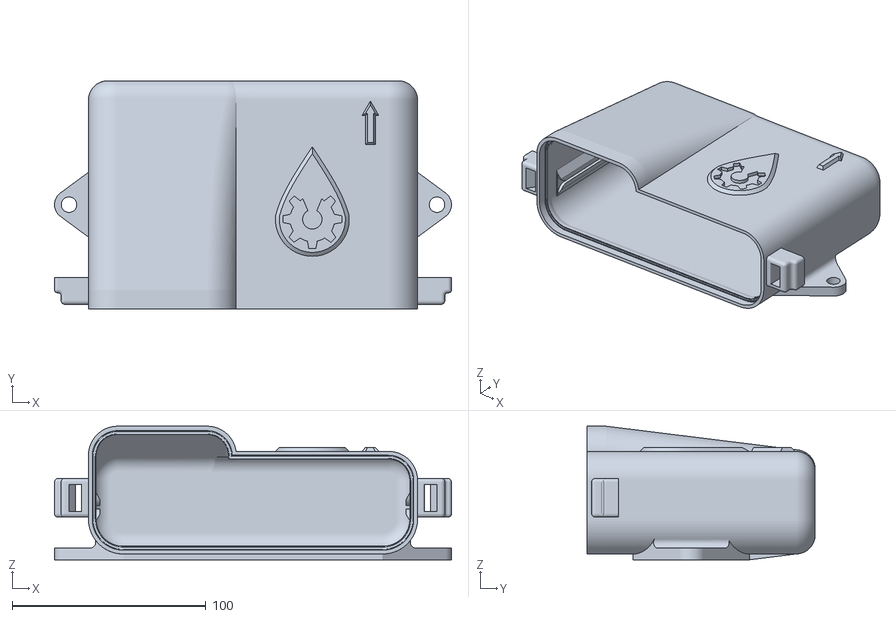
[picture p43: CAD file, 2023-02-05]
TeensyModules/V4.1/Enclosures/3Dprint/Micro_AMP/Box.stl
205.0 x 118.0 x 69.0
