rnibor/AgOpenGPS_BoardsKeya/TeensyModules/V4.1/Enclosures/3Dprint/Standard_AMP/Box.stl

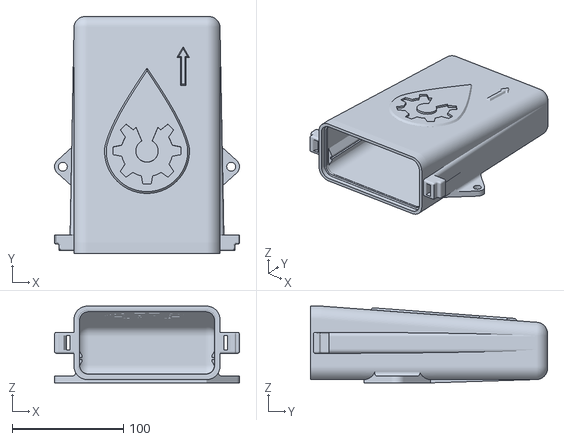
[picture p44: CAD file, 2023-02-05]
TeensyModules/V4.1/Enclosures/3Dprint/Standard_AMP/Box.stl
166.3 x 213.0 x 69.0
