rnibor/AgOpenGPS_BoardsKeya/TeensyModules/V4.1/Enclosures/3Dprint/Micro_Screws_AMP/Cover_AMP_Single.stl

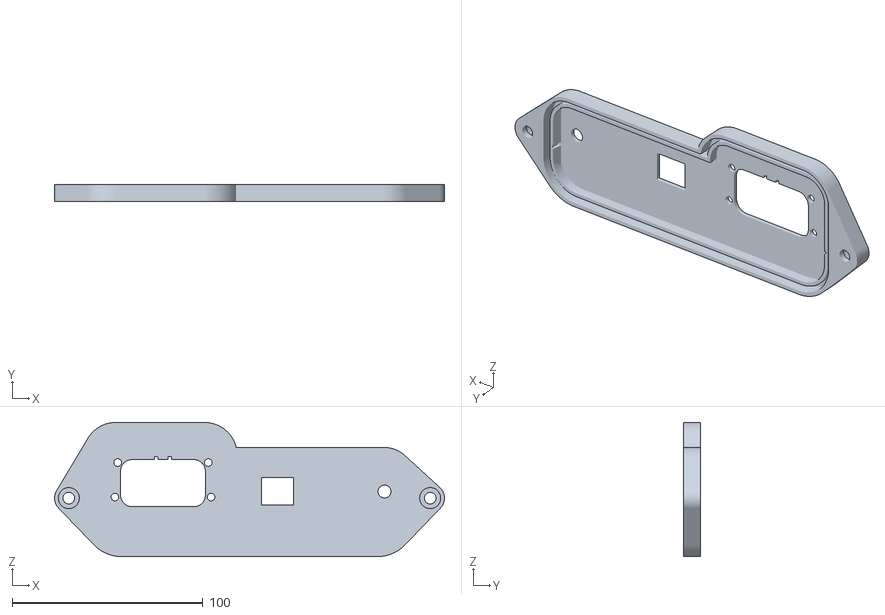
[picture p46: CAD file, 2023-02-05]
TeensyModules/V4.1/Enclosures/3Dprint/Micro_Screws_AMP/Cover_AMP_Single.stl
204.2 x 9.00 x 70.2
