rnibor/AgOpenGPS_BoardsKeya/TeensyModules/V4.1/Enclosures/3Dprint/Standard_Screws_AMP/Cover_AMP_Single.stl

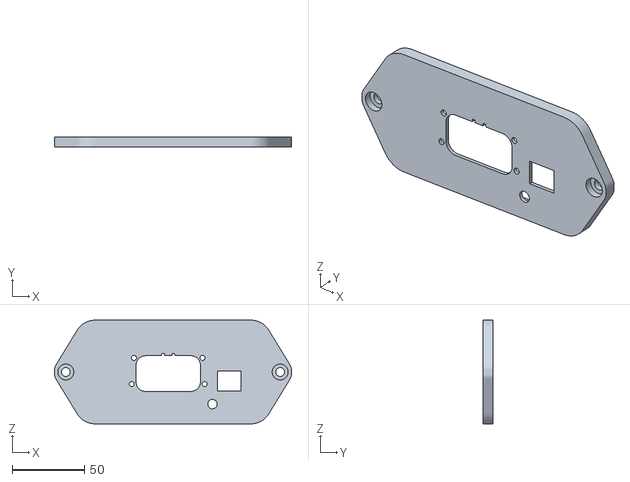
[picture p47: CAD file, 2023-02-05]
TeensyModules/V4.1/Enclosures/3Dprint/Standard_Screws_AMP/Cover_AMP_Single.stl
163.6 x 7.00 x 71.7
