rnibor/AgOpenGPS_BoardsKeya/TeensyModules/V4.1/Enclosures/3Dprint/Standard_Special_Screws_AMP/Box_Screws.stl

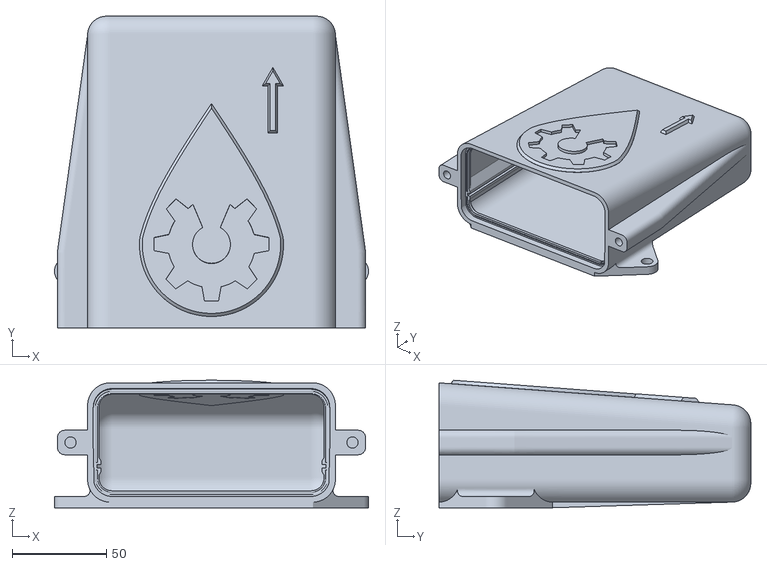
[picture p48: CAD file, 2023-02-05]
TeensyModules/V4.1/Enclosures/3Dprint/Standard_Special_Screws_AMP/Box_Screws.stl
166.3 x 165.0 x 67.5
