rnibor/AgOpenGPS_BoardsKeya/TeensyModules/V4.1/Enclosures/3Dprint/Standard_Special_Screws_AMP/Panel_AMP_Single_Screws.stl

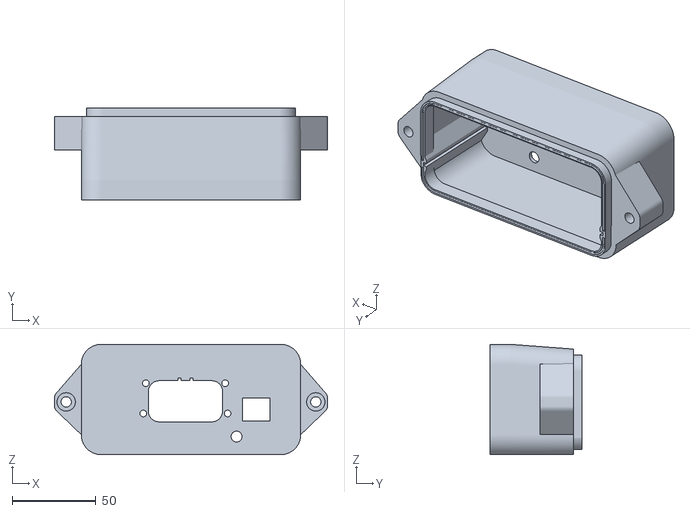
[picture p49: CAD file, 2023-02-05]
TeensyModules/V4.1/Enclosures/3Dprint/Standard_Special_Screws_AMP/Panel_AMP_Single_Screws.stl
163.2 x 55.0 x 66.0
