rnibor/AgOpenGPS_BoardsKeya/(list of files, cad)

Other CAD files:
TeensyModules/V4.1/Enclosures/3Dprint/Micro_AMP/FrontPanel_AMP_Dual.stl
TeensyModules/V4.1/Enclosures/3Dprint/Standard_AMP/FrontPanel_AMP_Single.stl
TeensyModules/V4.1/Enclosures/3Dprint/Standard_Special_AMP/Panel_AMP_Dual.stl
TeensyModules/V4.1/Enclosures/3Dprint/Micro_Screws_AMP/Box.stl
TeensyModules/V4.1/Enclosures/3Dprint/Standard_Screws_AMP/Cover_AMP_Dual.stl
TeensyModules/V4.1/Enclosures/3Dprint/Micro_Screws_AMP/Cover_AMP_Dual.stl
TeensyModules/V4.1/Enclosures/3Dprint/Standard_Screws_AMP/Box.stl
TeensyModules/V4.1/Enclosures/3Dprint/Standard_Special_Screws_AMP/Panel_AMP_Dual_Screws.stl
