rnibor/AgOpenGPS_BoardsKeya/TeensyModules/V4.5 Micro Keya/PCB Build/AIO v4.5 Micro Keya/boad3dImage.png

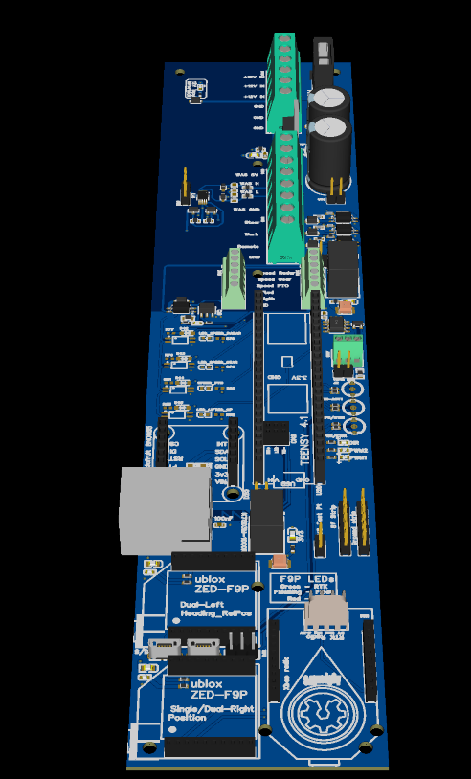
TeensyModules/V4.5 Micro Keya/PCB Build/AIO v4.5 Micro Keya/boad3dImage.png
