rnibor/AgOpenGPS_BoardsKeya/(list of files, drawings)

Other design files:
TeensyModules/4.1 STD/MISC/EasyEda Files/PCB_PCB_Autosteer Dual GPS V4.1 RELEASE (LOCKED)_2023-06-19.json
TeensyModules/4.1 STD/MISC/EasyEda Files/SCH_AiO V4 Standard_2023-06-19.json
