rnibor/AgOpenGPS_BoardsKeya/Support/TeensyModules/Firmware/Autosteer_gps_teensy_v5_5/zHandlers.ino

// Conversion to Hexidecimal
const char* asciiHex = "0123456789ABCDEF";

// the new PANDA sentence buffer
char nmea[100];

// GGA
char fixTime[12];
char latitude[15];
char latNS[3];
char longitude[15];
char lonEW[3];
char fixQuality[2];
char numSats[4];
char HDOP[5];
char altitude[12];
char ageDGPS[10];

// VTG
char vtgHeading[12] = { };
char speedKnots[10] = { };

// IMU
char imuHeading[6];
char imuRoll[6];
char imuPitch[6];
char imuYawRate[6];

// Send GGA buffer, interval and last time
char ggaNmea[100];
uint32_t ggaSendInterval = 0;
uint32_t ggaSendTime = 0;

// If odd characters showed up.
void errorHandler()
{
  //nothing at the moment
}

void GGA_Handler() //Rec'd GGA
{
    // fix time
    parser.getArg(0, fixTime);

    // latitude
    parser.getArg(1, latitude);
    parser.getArg(2, latNS);

    // longitude
    parser.getArg(3, longitude);
    parser.getArg(4, lonEW);

    // fix quality
    parser.getArg(5, fixQuality);

    // satellite #
    parser.getArg(6, numSats);

    // HDOP
    parser.getArg(7, HDOP);

    // altitude
    parser.getArg(8, altitude);

    // time of last DGPS update
    parser.getArg(12, ageDGPS);

    if (blink)
    {
        digitalWrite(GGAReceivedLED, HIGH);
    }
    else
    {
        digitalWrite(GGAReceivedLED, LOW);
    }

    blink = !blink;
    GGA_Available = true;

    if (useDual)
    {
       dualReadyGGA = true;
    }

    if (useBNO08x || useCMPS)
    {
       imuHandler();          //Get IMU data ready
       BuildNmea();           //Build & send data GPS data to AgIO (Both Dual & Single)
       dualReadyGGA = false;  //Force dual GGA ready false because we just sent it to AgIO based off the IMU data
       if (!useDual)
       {
        digitalWrite(GPSRED_LED, HIGH);    //Turn red GPS LED ON, we have GGA and must have a IMU     
        digitalWrite(GPSGREEN_LED, LOW);   //Make sure the Green LED is OFF     
       }
    }
    else if (!useBNO08x && !useCMPS && !useDual) 
    {
        digitalWrite(GPSRED_LED, blink);   //Flash red GPS LED, we have GGA but no IMU or dual
        digitalWrite(GPSGREEN_LED, LOW);   //Make sure the Green LED is OFF
        itoa(65535, imuHeading, 10);       //65535 is max value to stop AgOpen using IMU in Panda
        BuildNmea();
    }
    
    gpsReadyTime = systick_millis_count;    //Used for GGA timeout (LED's ETC)

    if (ggaSendInterval && systick_millis_count - ggaSendTime >= ggaSendInterval)
    {
        // Send gga to RTK Comport for VRS
        strcpy(ggaNmea, "");
        strcat(ggaNmea, "$GPGGA");

        uint8_t argCount = parser.argCount();
        char argBuffer[15] = {0};

        for (uint8_t i = 0; i < argCount; i++)
        {
            strcat(ggaNmea, ",");

            parser.getArg(i, argBuffer);
            strcat(ggaNmea, argBuffer);
        }

        strcat(ggaNmea, "*");
        CalculateChecksum(ggaNmea, 100);
        strcat(ggaNmea, "\r\n");

        SerialRTK.write(ggaNmea);
        SerialRTK.flush();

        // Save the current time
        ggaSendTime = systick_millis_count;
    }
}

void readBNO()
{
          if (bno08x.dataAvailable() == true)
        {
            float dqx, dqy, dqz, dqw, dacr;
            uint8_t dac;

            //get quaternion
            bno08x.getQuat(dqx, dqy, dqz, dqw, dacr, dac);
/*            
            while (bno08x.dataAvailable() == true)
            {
                //get quaternion
                bno08x.getQuat(dqx, dqy, dqz, dqw, dacr, dac);
                //Serial.println("Whiling");
                //Serial.print(dqx, 4);
                //Serial.print(F(","));
                //Serial.print(dqy, 4);
                //Serial.print(F(","));
                //Serial.print(dqz, 4);
                //Serial.print(F(","));
                //Serial.println(dqw, 4);
            }
            //Serial.println("End of while");
*/            
            float norm = sqrt(dqw * dqw + dqx * dqx + dqy * dqy + dqz * dqz);
            dqw = dqw / norm;
            dqx = dqx / norm;
            dqy = dqy / norm;
            dqz = dqz / norm;

            float ysqr = dqy * dqy;

            // yaw (z-axis rotation)
            float t3 = +2.0 * (dqw * dqz + dqx * dqy);
            float t4 = +1.0 - 2.0 * (ysqr + dqz * dqz);
            yaw = atan2(t3, t4);

            // Convert yaw to degrees x10
            correctionHeading = -yaw;
            yaw = (int16_t)((yaw * -RAD_TO_DEG_X_10));
            if (yaw < 0) yaw += 3600;

            // pitch (y-axis rotation)
            float t2 = +2.0 * (dqw * dqy - dqz * dqx);
            t2 = t2 > 1.0 ? 1.0 : t2;
            t2 = t2 < -1.0 ? -1.0 : t2;
//            pitch = asin(t2) * RAD_TO_DEG_X_10;

            // roll (x-axis rotation)
            float t0 = +2.0 * (dqw * dqx + dqy * dqz);
            float t1 = +1.0 - 2.0 * (dqx * dqx + ysqr);
//            roll = atan2(t0, t1) * RAD_TO_DEG_X_10;

            if(swapRollPitch)
            {
              roll = asin(t2) * RAD_TO_DEG_X_10;
              pitch = atan2(t0, t1) * RAD_TO_DEG_X_10;
            }
            else
            {
              pitch = asin(t2) * RAD_TO_DEG_X_10;
              roll = atan2(t0, t1) * RAD_TO_DEG_X_10;
            }
            if(invertRoll)
            {
              roll *= -1;
            }
        }
}

void imuHandler()
{
    int16_t temp = 0;

    if (useCMPS)
    {
        //the heading x10
        Wire.beginTransmission(CMPS14_ADDRESS);
        Wire.write(0x1C);
        Wire.endTransmission();

        Wire.requestFrom(CMPS14_ADDRESS, 3);
        while (Wire.available() < 3);

        roll = int16_t(Wire.read() << 8 | Wire.read());
        if(invertRoll)
        {
          roll *= -1;
        }

        // the heading x10
        Wire.beginTransmission(CMPS14_ADDRESS);
        Wire.write(0x02);
        Wire.endTransmission();

        Wire.requestFrom(CMPS14_ADDRESS, 3);
        while (Wire.available() < 3);

        temp = Wire.read() << 8 | Wire.read();
        correctionHeading = temp * 0.1;
        correctionHeading = correctionHeading * DEG_TO_RAD;
        itoa(temp, imuHeading, 10);

        // 3rd byte pitch
        int8_t pitch = Wire.read();
        itoa(pitch, imuPitch, 10);

        // the roll x10
        temp = (int16_t)roll;
        itoa(temp, imuRoll, 10);

        // YawRate - 0 for now
        itoa(0, imuYawRate, 10);
    }

    if (useBNO08x)
    {
        //BNO is reading in its own timer    
        // Fill rest of Panda Sentence - Heading
        temp = yaw;
        itoa(temp, imuHeading, 10);

        // the pitch x10
        temp = (int16_t)pitch;
        itoa(temp, imuPitch, 10);

        // the roll x10
        temp = (int16_t)roll;
        itoa(temp, imuRoll, 10);

        // YawRate - 0 for now
        itoa(0, imuYawRate, 10);
    }

    // No else, because we want to use dual heading and IMU roll when both connected
    if (useDual)
    {
        // We have a IMU so apply the dual/IMU roll/heading error to the IMU data.
        if (useCMPS || useBNO08x)
        {
            float dualTemp;   //To convert IMU data (x10) to a float for the PAOGI so we have the decamal point
                     
            // the IMU heading raw
//            dualTemp = yaw * 0.1;
//            dtostrf(dualTemp, 3, 1, imuHeading);          

            // the IMU heading fused to the dual heading
            fuseIMU();
            dtostrf(imuCorrected, 3, 1, imuHeading);
          
            // the pitch
            dualTemp = (int16_t)pitch * 0.1;
            dtostrf(dualTemp, 3, 1, imuPitch);

            // the roll
            dualTemp = (int16_t)roll * 0.1;
            //If dual heading correction is 90deg (antennas left/right) correct the IMU roll
            if(headingcorr == 900)
            {
              dualTemp += rollDeltaSmooth;
            }

            dtostrf(dualTemp, 3, 1, imuRoll);

        }
        else  //No IMU so put dual Heading & Roll in direct.
        {
            // the roll
            dtostrf(rollDual, 3, 1, imuRoll);
            
            // the Dual heading raw
            dtostrf(heading, 3, 1, imuHeading);            
        }
    }
}

void BuildNmea(void)
{
    strcpy(nmea, "");

    if (useDual) strcat(nmea, "$PAOGI,");
    else strcat(nmea, "$PANDA,");

    strcat(nmea, fixTime);
    strcat(nmea, ",");

    strcat(nmea, latitude);
    strcat(nmea, ",");

    strcat(nmea, latNS);
    strcat(nmea, ",");

    strcat(nmea, longitude);
    strcat(nmea, ",");

    strcat(nmea, lonEW);
    strcat(nmea, ",");

    // 6
    strcat(nmea, fixQuality);
    strcat(nmea, ",");

    strcat(nmea, numSats);
    strcat(nmea, ",");

    strcat(nmea, HDOP);
    strcat(nmea, ",");

    strcat(nmea, altitude);
    strcat(nmea, ",");

    //10
    strcat(nmea, ageDGPS);
    strcat(nmea, ",");

    //11
    strcat(nmea, speedKnots);
    strcat(nmea, ",");

    //12
    strcat(nmea, imuHeading);
    strcat(nmea, ",");

    //13
    strcat(nmea, imuRoll);
    strcat(nmea, ",");

    //14
    strcat(nmea, imuPitch);
    strcat(nmea, ",");

    //15
    strcat(nmea, imuYawRate);

    strcat(nmea, "*");

    CalculateChecksum(nmea, 100);

    strcat(nmea, "\r\n");

    if (!passThroughGPS && !passThroughGPS2)
    {
        //SerialAOG.write(nmea);  //Always send USB GPS data
    }

    if (Ethernet_running)   //If ethernet running send the GPS there
    {
        int len = strlen(nmea);
        Eth_udpPAOGI.beginPacket(Eth_ipDestination, portDestination);
        Eth_udpPAOGI.write(nmea, len);
        Eth_udpPAOGI.endPacket();
    }
}

void CalculateChecksum(char* nmeaBuffer, int16_t length)
{
  int16_t sum = 0;
  int16_t inx = 0;
  char tmp;

  // The checksum calc starts after '$' and ends before '*'
  for (inx = 1; inx < length; inx++)
  {
    tmp = nmeaBuffer[inx];

    // * Indicates end of data and start of checksum
    if (tmp == '*')
    {
      break;
    }

    sum ^= tmp;    // Build checksum
  }

  byte chk = (sum >> 4);
  char hex[2] = { asciiHex[chk], 0 };
  strcat(nmeaBuffer, hex);

  chk = (sum % 16);
  char hex2[2] = { asciiHex[chk], 0 };
  strcat(nmeaBuffer, hex2);
}

/*
  $PANDA
  (1) Time of fix

  position
  (2,3) 4807.038,N Latitude 48 deg 07.038' N
  (4,5) 01131.000,E Longitude 11 deg 31.000' E

  (6) 1 Fix quality:
    0 = invalid
    1 = GPS fix(SPS)
    2 = DGPS fix
    3 = PPS fix
    4 = Real Time Kinematic
    5 = Float RTK
    6 = estimated(dead reckoning)(2.3 feature)
    7 = Manual input mode
    8 = Simulation mode
  (7) Number of satellites being tracked
  (8) 0.9 Horizontal dilution of position
  (9) 545.4 Altitude (ALWAYS in Meters, above mean sea level)
  (10) 1.2 time in seconds since last DGPS update
  (11) Speed in knots

  FROM IMU:
  (12) Heading in degrees
  (13) Roll angle in degrees(positive roll = right leaning - right down, left up)

  (14) Pitch angle in degrees(Positive pitch = nose up)
  (15) Yaw Rate in Degrees / second

  CHKSUM
*/

/*
  $GPGGA,123519,4807.038,N,01131.000,E,1,08,0.9,545.4,M,46.9,M ,  ,*47
   0     1      2      3    4      5 6  7  8   9    10 11  12 13  14
        Time      Lat       Lon     FixSatsOP Alt
  Where:
     GGA          Global Positioning System Fix Data
     123519       Fix taken at 12:35:19 UTC
     4807.038,N   Latitude 48 deg 07.038' N
     01131.000,E  Longitude 11 deg 31.000' E
     1            Fix quality: 0 = invalid
                               1 = GPS fix (SPS)
                               2 = DGPS fix
                               3 = PPS fix
                               4 = Real Time Kinematic
                               5 = Float RTK
                               6 = estimated (dead reckoning) (2.3 feature)
                               7 = Manual input mode
                               8 = Simulation mode
     08           Number of satellites being tracked
     0.9          Horizontal dilution of position
     545.4,M      Altitude, Meters, above mean sea level
     46.9,M       Height of geoid (mean sea level) above WGS84
                      ellipsoid
     (empty field) time in seconds since last DGPS update
     (empty field) DGPS station ID number
      47          the checksum data, always begins with


  $GPRMC,123519,A,4807.038,N,01131.000,E,022.4,084.4,230394,003.1,W*6A
  0      1    2   3      4    5      6   7     8     9     10   11
        Time      Lat        Lon       knots  Ang   Date  MagV

  Where:
     RMC          Recommended Minimum sentence C
     123519       Fix taken at 12:35:19 UTC
     A            Status A=active or V=Void.
     4807.038,N   Latitude 48 deg 07.038' N
     01131.000,E  Longitude 11 deg 31.000' E
     022.4        Speed over the ground in knots
     084.4        Track angle in degrees True
     230394       Date - 23rd of March 1994
     003.1,W      Magnetic Variation
      6A          The checksum data, always begins with

  $GPVTG,054.7,T,034.4,M,005.5,N,010.2,K*48

    VTG          Track made good and ground speed
    054.7,T      True track made good (degrees)
    034.4,M      Magnetic track made good
    005.5,N      Ground speed, knots
    010.2,K      Ground speed, Kilometers per hour
     48          Checksum
*/

void VTG_Handler()
{
  // vtg heading
  parser.getArg(0, vtgHeading);

  // vtg Speed knots
  parser.getArg(4, speedKnots);


}
