rnibor/AgOpenGPS_BoardsKeya/(commit log)

2023-03-02 Remove outdated old CANBUS WAS & valve code
2023-03-02 Add original triple CAN PCB
    [Teensy LCSC Parts.xlsx]
2023-03-03 Swap old Panda schematic to correct one
2023-03-03 Add Andy's modified version for AIO PCB
    [Teensy LCSC Parts.xlsx]
2023-03-08 Add v3
    [BOM_PCB_AOG All-in-One Micro V2.4 Ampseal_2022-11-09.csv, BOM_PCB_AOG All-in-One Micro V3.0 Ampseal Basic Motor_2023-02-03.csv, BOM_PCB_Autosteer Dual GPS V5_v2.4_AMPSEAL_2022-11-09.csv, Box.stl, Box_Screws.stl, Cover_AMP_Dual.stl, Cover_AMP_Single.stl, FrontPanel_AMP_Dual.stl]
2023-03-09 Fix Roll Pitch in Ard Module
    [Autosteer_UDP_v5.ino, Autosteer_USB_v5.ino]
2023-03-10 Create rest of v3 Folders
    [Box.stl, Box_Screws.stl, Cover_AMP_Dual.stl, Cover_AMP_Single.stl, FrontPanel_AMP_Dual.stl, FrontPanel_AMP_Single.stl, Panel_AMP_Dual.stl, Panel_AMP_Dual_Screws.stl]
2023-03-10 Remove CMPS and WireBNO
2023-03-10 remove v3
    [Box.stl, Box_Screws.stl, Cover_AMP_Dual.stl, Cover_AMP_Single.stl, FrontPanel_AMP_Dual.stl, FrontPanel_AMP_Single.stl, Panel_AMP_Dual.stl, Panel_AMP_Dual_Screws.stl]
2023-03-16 Make sure sensorReading does not go above 255
2023-04-09 Add enclosure
    [Box.stl, Box_Screws.stl, Cover_AMP_Dual.stl, Cover_AMP_Single.stl, FrontPanel_AMP_Dual.stl, FrontPanel_AMP_Single.stl, Panel_AMP_Dual.stl, Panel_AMP_Dual_Screws.stl]
2023-04-27 comment imu code
2023-04-28 Add Wire.end() to all begins
2023-05-12 Roll Baseline fix, danfoss line in
    [zHandlers.ino]
2023-06-19 Release 4.1 Standard board
    Added all files into 4.1 STD folder
    [BOM_AiO V4 Standard_2023-06-19.csv, PCB_PCB_Autosteer Dual GPS V4.1 RELEASE (LOCKED)_2023-06-19.json, PickAndPlace_PCB_Autosteer Dual GPS V4.1 RELEASE (LOCKED)_2023-06-19.csv, SCH_AiO V4 Standard_2023-06-19.json]
2023-06-29 Fixed the connection between 12V and 24V input
    Fixed the connection between 12V and 24V input for Cytron.
    Cytron AUX had a via that was directly connected to 12V on v4.1, it was decided to do a v4.2 to address this
2023-08-04 Added 1.13 Single Antenna Rover config file
2023-10-07 Added Teensyloader to the 4.1 firmware folder
2024-08-05 - Scheme divided into several pages - Motor and valve control deleted - Interface to tractor according to ISO 11786 added - No Ampseal connector but several screw terminals - Longer format so that th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
    [AgOpenGpsV4.5MicroKeyaBottom.step, AgOpenGpsV4.5MicroKeyaTop.step, BOM_AiO v4 Micro Robin_PCB_AIO v4.5 Micro AMP 2024 Robin_2024-07-01.xlsx, OTHER USEFULL PARTS.xlsx, PickAndPlace_PCB_AIO v4.5 Micro AMP 2024 Robin_2024-07-01.xlsx]
